UniKlo/PaintBot/README.md

# PaintBot
Paintbot is a machine that paints upright surfaces. It's a prototype that can paint indoor walls. The goal of this prototype is to extend it to paint or draw on walls of any size, indoors and outdoors alike. This document is a wiki for the robot's mechanics, electronics and code.<br/>

| Overview | Demonstration |
:-------------------------:|:-------------------------:
paintbot_v12 |  <br/> Autonomously paints a 3'x 3' square on the wall <br/> [Youtube link](https://www.youtube.com/watch?v=X723J_k0E64&feature=youtu.be)

## Parts
| | **Part** | **Description** |
:---:|:-------------------------:|:-------------------------
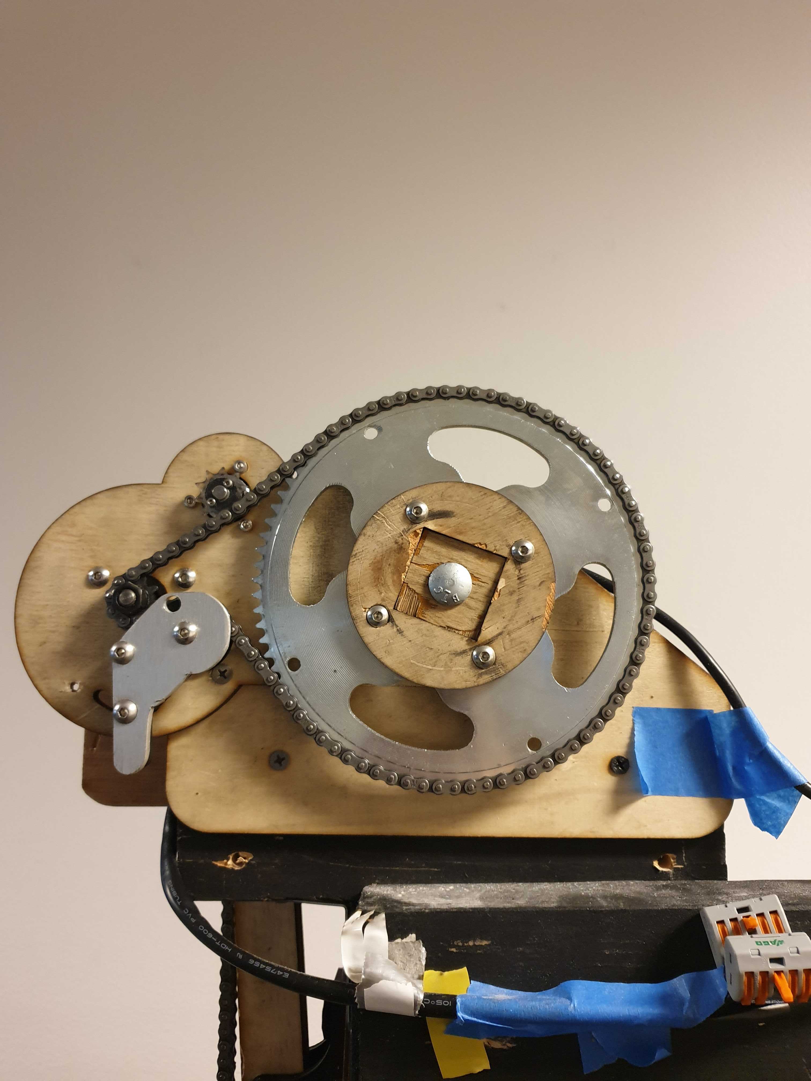
[picture p1: img_gif/motor_rack_with_tensioner_H.jpg]
A. | **Motor Rack with Tensioner** <br/>  | Device that controls the movement of the centerpiece and spray gun by feeding or withdrawing chain from opposite ends <br/><br/> [Design goals, parts, CAD drawings/documents](https://github.com/UniKlo/PaintBot/tree/master/Mechanics/MotorRack) <br/><br/> [How to assemble](https://github.com/UniKlo/PaintBot/blob/master/Mechanics/How%20to%20Assemble/Motor%20Rack%20with%20Tensioner/README.md)
B. | **Frame** <br/>  | <br/> Structure, created with 2" x 4" wood studs, to provide an exoskeleton for the Paintbot <br/><br/> [Design goals](https://github.com/UniKlo/PaintBot/tree/master/Mechanics/Pillar) <br/><br/> [How to assemble](https://github.com/UniKlo/PaintBot/blob/master/Mechanics/How%20to%20Assemble/Frame/README.md)
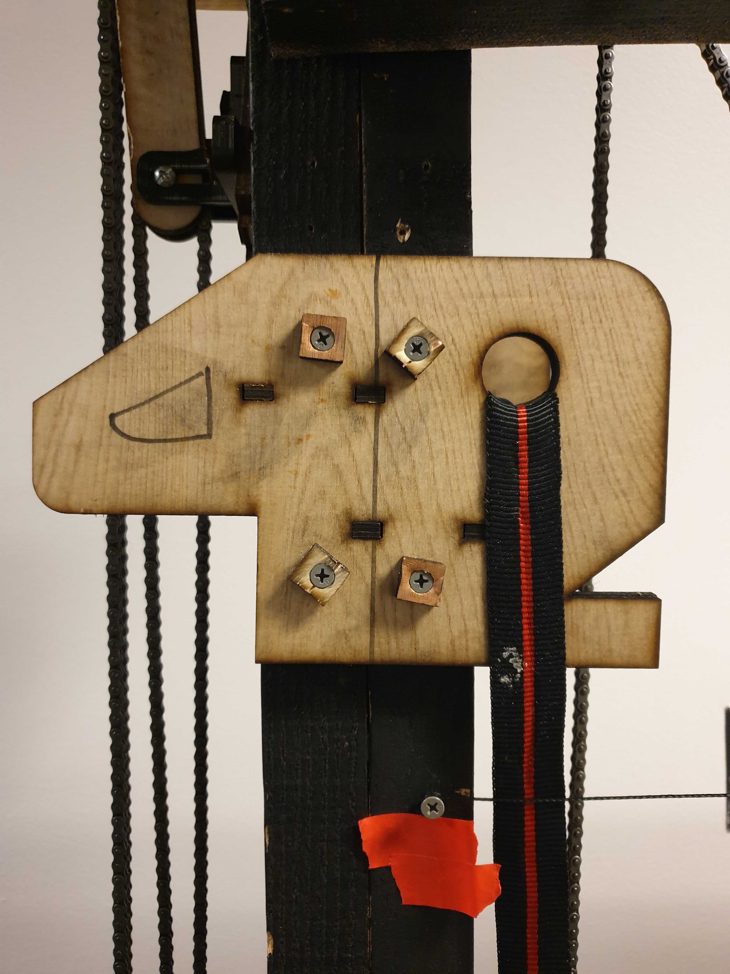
[picture p2: img_gif/safety_brace_H.jpg]
C. | **Safety Brace** <br/>  | Passive device that acts as a physical barrier to prevent the pulley weights from colliding with the bracket under "Motor Rack with Tensioner part" <br/> - Other functions include: <br/> -- Preventing the pulley weights from descending too low <br/> -- Catching the pulley weights in case of chain system failure <br/> -- Strapping the pulley weights in place during transportation of the PaintBot <br/> - Note: Ratchet straps are used in coordination with this passive device <br/> There are a total of 4 Safety Braces on the Frame (2 on the front and back of each pillar) <br/><br/> [Design goals, Force Diagrams, and CAD drawing/documents](https://github.com/UniKlo/PaintBot/blob/master/Mechanics/Safety%20Brace/README.md) <br/><br/> [How to Assemble](https://github.com/UniKlo/PaintBot/blob/master/Mechanics/How%20to%20Assemble/Safety%20Brace/README.md)
D. | **Control Box** <br/> Control Box | Plywood box designed to protect all microelectronics used to receive input or output signal to motors against physical and liquid hazards <br/> [Wiring Schematics, Connections, and Parts](https://github.com/UniKlo/PaintBot/tree/master/Mechanics/Electric%20Circuits)
E. | **Paint Compressor** <br/> Paint Compressor | Magnum Project Painter Plus Electric TrueAirless Sprayer <br/> - Device used to pressurize and spray paint <br/> **Recommendations: For an even coat, each spray layer should have 50% overlay and the spray gun should be 1 foot away from the wall** <br/><br/> [Design considerations](https://github.com/UniKlo/PaintBot/tree/master/Mechanics/Paint%20Compressor) <br/><br/> [How to Connect/Use (Youtube Video by GracoPaintSprayers)](https://www.youtube.com/watch?v=pey29Z3UQR4)
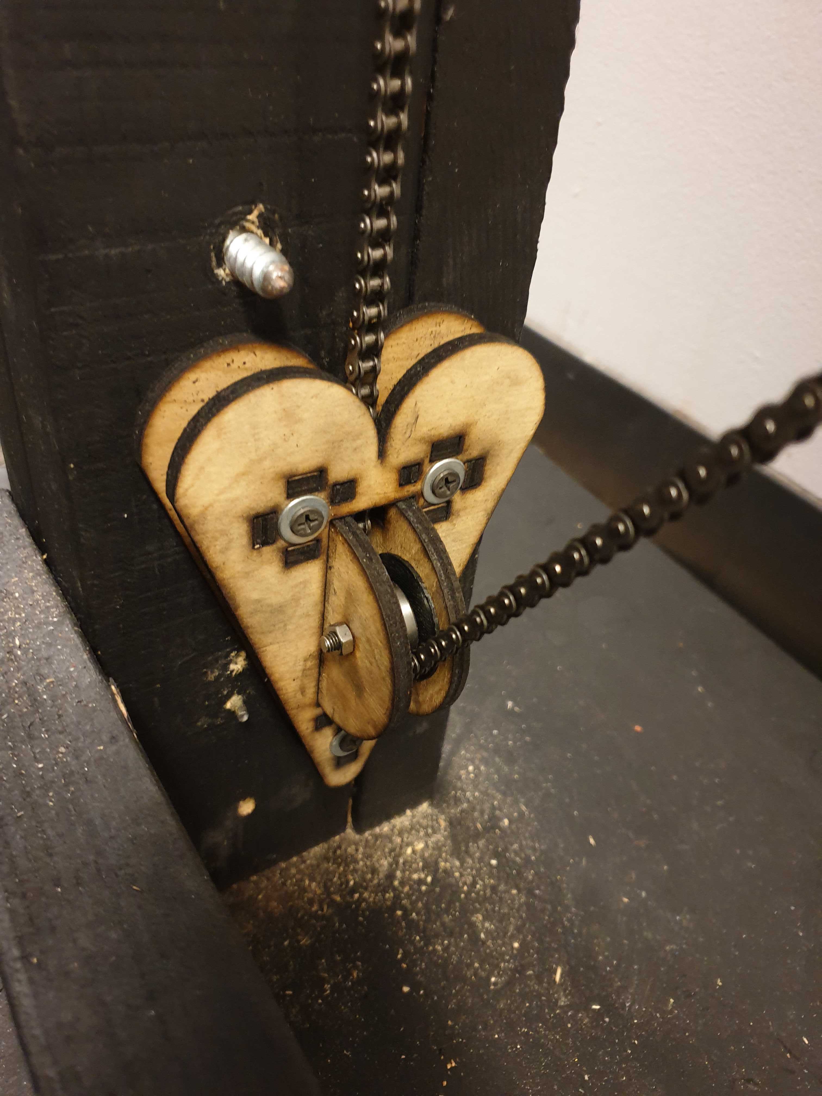
[picture p3: img_gif/safety brackets.jpg]
F. | **Wooden Bracket** <br/> | Device that is designed to handle forces from the tension in the chain system by holding the chain in place during operations <br/><br/> [Design Goals, Force Diagrams, CAD Drawings/Documents](https://github.com/UniKlo/PaintBot/blob/master/Mechanics/Wooden%20Bracket/README.md) <br/> <br/> [How to Assemble](https://github.com/UniKlo/PaintBot/blob/master/Mechanics/How%20to%20Assemble/Wooden%20Bracket/README.md)
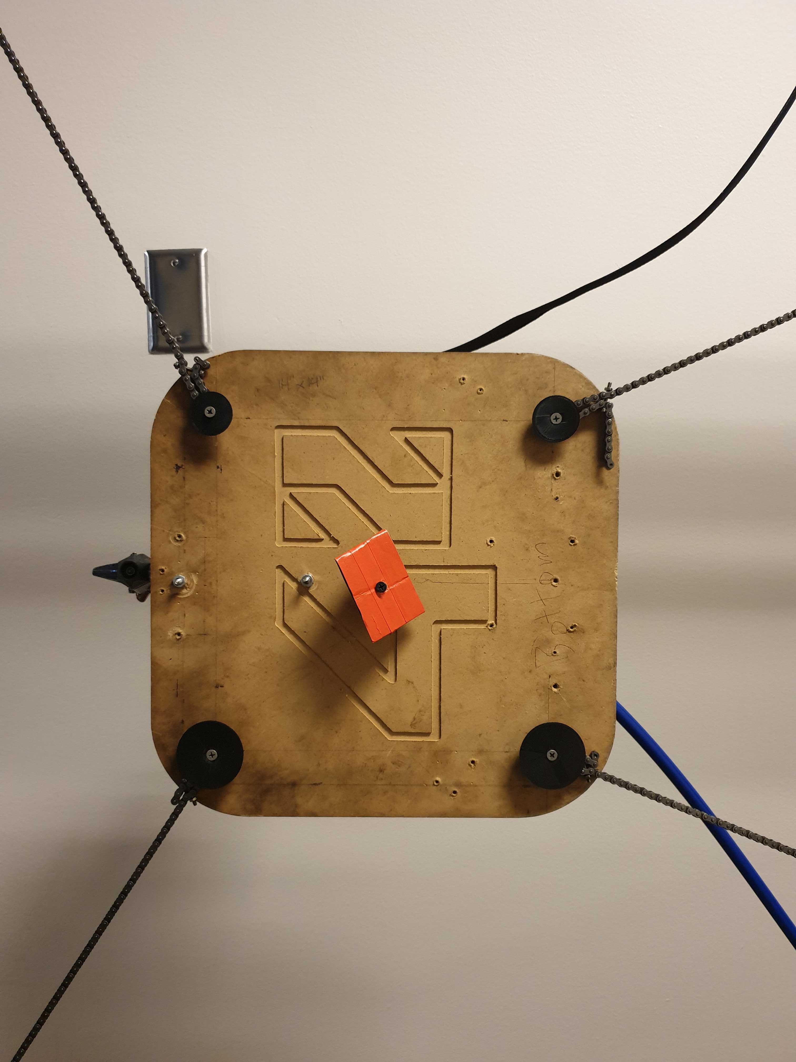
[picture p4: img_gif/center_piece_H.jpg]
G. | **Centerpiece** <br/>  | Placeholder for spray-gun to ensure proper upright position during spraying <br/><br/> [Design goals, Force diagrams, CAD drawing/documents, and Iterations](https://github.com/UniKlo/PaintBot/tree/master/Mechanics/Centerpiece)
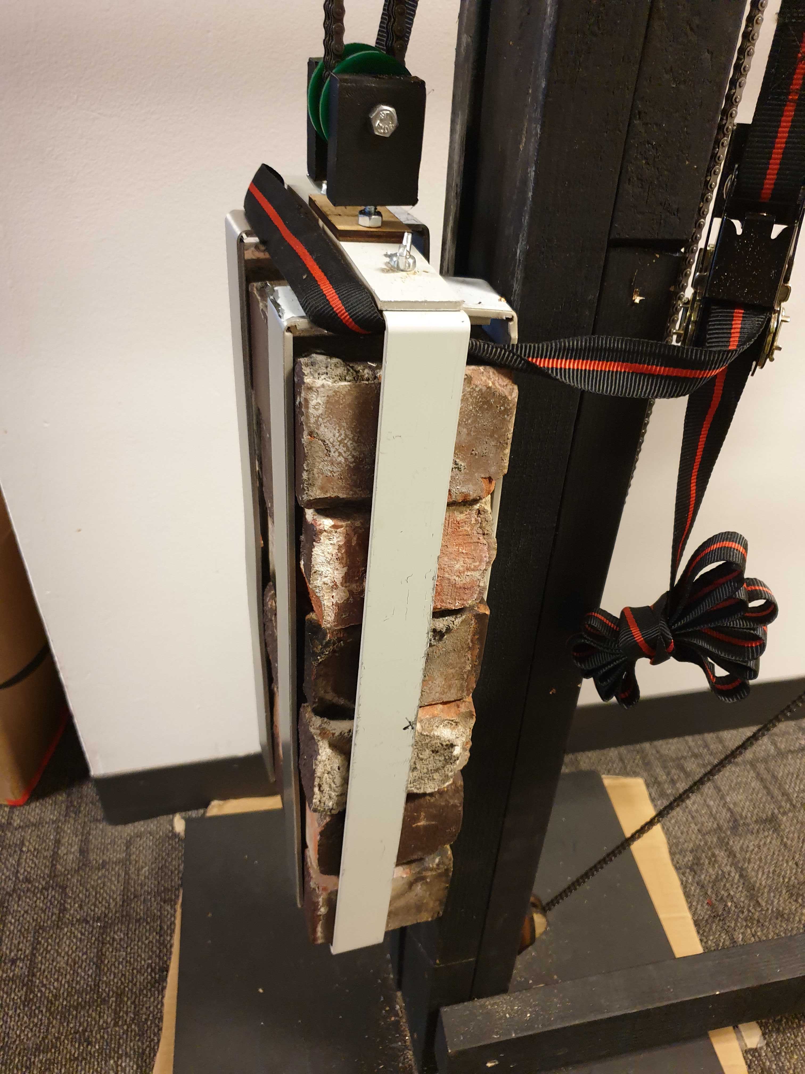
[picture p5: img_gif/pulley weights.jpg]
H. | **Pulley Weight** <br/>   |  Weights used to create tension in our chains to allow Cartesian control <br/><br/> [Design Goals](https://github.com/UniKlo/PaintBot/tree/master/Mechanics/PulleyWeights) <br/> <br/> [How to Assemble](https://github.com/UniKlo/PaintBot/blob/master/Mechanics/How%20to%20Assemble/Pulley%20Weights/README.md)
I. | **Spray Gun Holder** <br/>  | Encasing used to hold the spray gun upright and controls whether to engage or disengage spraying during operation <br/><br/> [Design goals, Parts, CAD drawing/documents](https://github.com/UniKlo/PaintBot/tree/master/Mechanics/SprayGunHolder) <br/><br/> [How to assemble](https://github.com/UniKlo/PaintBot/tree/master/Mechanics/How%20to%20Assemble/Spray%20Gun%20Holder)
J. | **Chain system** <br/> Chain System | Pulley System developed with #25 ANSI Standard Roller Chains to utilize the torque in the motor to control the movement of the Centerpiece in Cartesian plane <br/><br/> [Design considerations, Force diagrams, Parts, and More Photos](https://github.com/UniKlo/PaintBot/blob/master/Mechanics/ChainSystem/README.md) <br/><br/> [Chain Layout](https://github.com/UniKlo/PaintBot/blob/master/Mechanics/How%20to%20Assemble/Chain%20System/README.md)

## Code

### [Working Code](https://github.com/UniKlo/PaintBot/tree/master/DEMO_code)
* Code that was developed in Arduino IDE and uses the readings from the encoders, inside the Motor Rack, to control the displacement of the centerpiece so the PaintBot could spray a 3ft. x 3ft. area on the wall.
* Demonstration conducted on 2019.11.12

### [Future Code (Work in progress)](https://github.com/UniKlo/PaintBot/tree/master/Automatic_Controls)
* Alternative code developed in Arduino IDE using displacement of chain distance to control the movement of the centerpiece during operation. This method uses the relative starting point of the centerpiece as the origin and traverses by vector notation inputs. 

## Previous Iterations
 * [V-Plotter](https://github.com/UniKlo/PaintBot/tree/master/Iterations/V-Plotter)
