UniKlo/PaintBot/DEMO_code/README.md

Paint Bot Image

### Prerequisites

```
Arduino Mega 2560 Rev3 (recommended) or Arduino Uno Rev3
Any computer (Mac OS X, WINDOW, LINUX) to run Arduino IDE
```

### Installing

git clone the repository or download the zip file, then go to paintbot folder

```
$ git clone https://github.com/movingfinger/hardware-piscine.git
$ cd hardware-piscine/
$ cd paintbot/
open paintbot.ino with Arduino IED.
```

installing images

## Running the tests

Paint Bot (https://youtu.be/X723J_k0E64 "Paint Bot")

## Acknowledgments

* 42 Silicon Valley
* 42 Robolab
