UniKlo/PaintBot/Mechanics/Electric Circuits/README.md

# Electric Circuits

## Wiring

Breadboard used to connect all 5V(+) and all GND(-) to Arduino's 5V and GND output<br/>
Motors connections must be PWM enabled and Encoders must be Interrupt enabled pins



## Connections

| Part | Description |
| :---: | :--- |
**Arduino** <br/> Arduino Mega 2560 |  All microelectronics server, controling actions by analogic and digital inputs and outputs <br/> <br/> [Arduino Mega 2560 Rev3](https://store.arduino.cc/usa/mega-2560-r3)
**Power Supply** <br/> MENZO 12 Volts Power Supply | Transforms power outlet output to safe input for all microelectronics <br/> <br/> [MENZO 12v 30a Dc Universal Regulated Switching Power Supply 360w](https://www.amazon.com/MENZO-Universal-Regulated-Switching-Computer/dp/B06VWV5YCH)
**Joystick** <br/> Joystick | Mannualy controls the centerpiece x and y axis movement and activate the path coded <br/> <br/> [Game Controller Sensor JoyStick](https://www.amazon.com/HiLetgo-Controller-JoyStick-Breakout-Arduino/dp/B00P7QBGD2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)
**H-Bridge** <br/>  | Controls the output signal to the motors so they can operate safely within specifications <br/> <br/> [IBT-2 H-Bridge with Arduino](http://www.hessmer.org/blog/2013/12/28/ibt-2-h-bridge-with-arduino/)
**Rotary Encoder** <br/> Rotary Encoder | Keeps track of the chain motor rotation, furthermore transfering that information to the Arduino(Code) <br/> <br/> [Optical encoder 360 ppr LPD3806-360BM-24C AB Two Phase Incremental optical shaft 6mm Rotary Encoder 360 Pulses lines](https://sdgteach.en.alibaba.com/product/60729529433-806678094/Optical_encoder_360_ppr_LPD3806_360BM_G5_24C_AB_Two_Phase_Incremental_optical_shaft_6mm_Rotary_Encoder_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)
**Motor** <br/> Scooter Motor | Controls the chain-centerpiece movement <br/> <br/> [24 Volt 100 Watt MY6812 Electric Motor with 9 Tooth #25 Chain Sprocket](https://www.monsterscooterparts.com/rae124vo100w.html)
**Z Motor** <br/> Z-Axis motor | Controls the rotation of the Trigger control piece <br/> <br/> [Motor from MakerMadeCNC.com](https://www.makermadecnc.com/product/z-axis-replacement-motor/)
