UniKlo/PaintBot/Mechanics/PulleyWeights/README.md

# Pulley Weight


## Design Goals
* Develop control in 2D Cartesian plane with the use of tension in the chains
  * Achieved by using a pulley system with weights to create tension
* Minimum cost
  * Bricks were readily available (other forms of weights can be used)
  * Encasing was custom-made from aluminum scraps to hold bricks

## Parts
| | Part | Description |
|:-| :--:| :--- |
A. | **Weight Connect** <br/>  | 3D printed part used to connect the metal encasing to to pulley system <br/> printed with 70% infill <br/><br/> [Fusion document](https://a360.co/2piFbqn)
B. | **acrylic cut chain guide** <br/>  | 3D printed bearing shaft used to guide the chains holding the pulley weight
C. | **Brick** <br/> Brick | Clay bricks (~2.3 kg ea) layered on top of each other encased in a metal frame <br/> 6 bricks were used, giving an approximate of 13 kg <br/><br/> [4 in. x 2 in. x 8 in. Red Concrete Brick](https://www.homedepot.com/p/4-in-x-2-in-x-8-in-Red-Concrete-Brick-100003009/100321940)
