UniKlo/PaintBot/Mechanics/ChainSystem/README.md

# Chain System

The goal of the centerpiece is to be able to move to any edge of the painting frame while constrained at each corner by tensioned chains. Via pulleys, the chain system allows that to happen by creating a pulling force via weights and by shortening the chain.

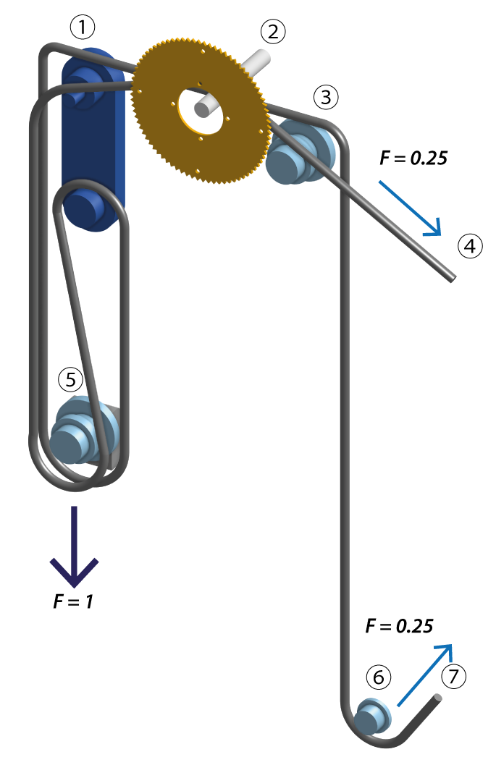
[picture p6: Mechanics/ChainSystem/chain-system-02-01.png]


1. Double Bearing Pulley that guides the chains through the Motor Rack.
2. 10 teeth #25 sprocket, connected to bolt, that drives the motion of the chains by using the torque translated from the motor inside the [Motor Rack](https://github.com/UniKlo/PaintBot/tree/master/Mechanics/MotorRack).
3. Double Bearing that guides the chains to the Wooden Bracket and to the Centerpiece
4. Connection to Top Corner of Centerpiece
5. Weight holder connects to [Pulley Weight](https://github.com/UniKlo/PaintBot/tree/master/Mechanics/PulleyWeights) to add tension to the system.
6. Single bearing attached to bottom of the pillar, encased in [Wooden Bracket](https://github.com/UniKlo/PaintBot/blob/master/Mechanics/Wooden%20Bracket).
7. Connection to Bottom Corner of Centerpiece

## Design considerations

* Develop a chain system that keeps the centerpiece stable during operation
  * Centerpiece held in place from the tension of two equal weights on opposite sides
  * The tension in the chains stables and prevents the Centerpiece from vibrating violently during spraying
* Increase efficency and safety during operations
  * Increasing mechanical advantage by using 1:4 Pulley System: Refer to diagram below.
  * Limit the range of distance the Pulley Weight travels while increase operating range of centerpiece 
    * Limiting the distance the Pulley Weight travels reduces the likelihood of it colliding with people underneath
    * Increasing operating range of centerpiece is practical in achieving more paint coverage

Pulley Systems

## Parts
| Part | Description |
| :--: | :-- |
**ANSI #25 Roller Chain** <br/> 25 ANSi Chain | - ANSI Chain No. 25 used to connect the pulley systems <br/> - 140 lbs is the rated working load of the chain <br/> - [Specifications](https://www.renoldjeffrey.com/media/2395574/ansi-standard-roller-chain-renold-jeffrey.pdf)

## Photos
| &nbsp; | &nbsp; | &nbsp; |
|:-:|:-:|:-:|
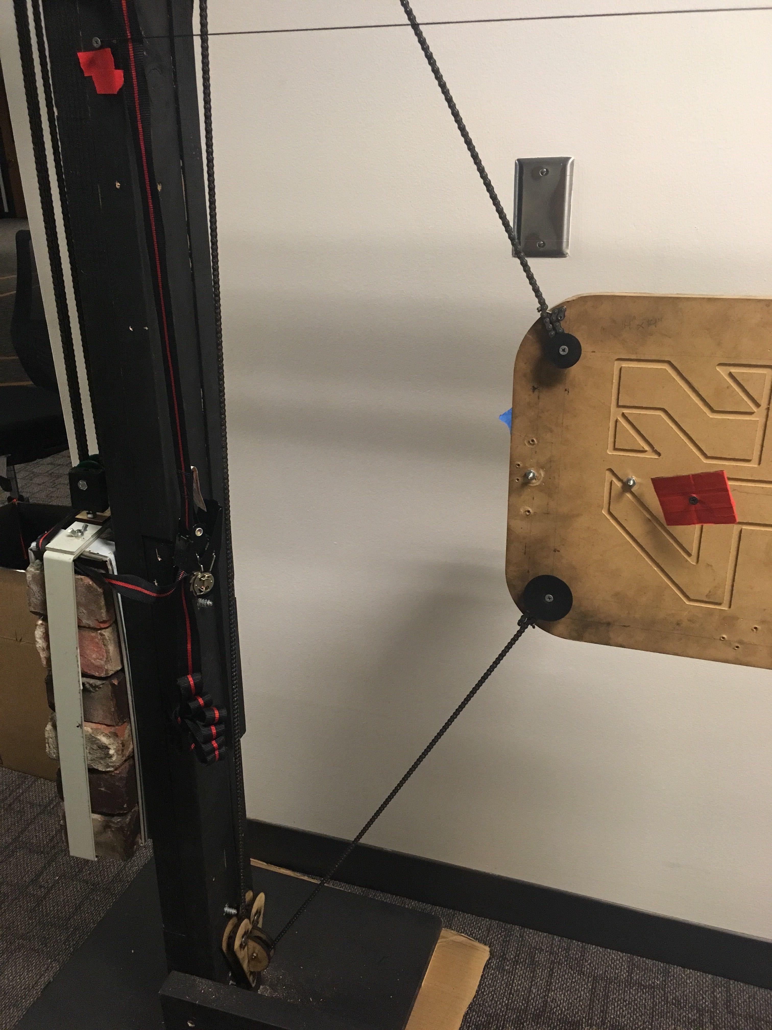
[picture p7: Mechanics/ChainSystem/Image from iOS.jpg]
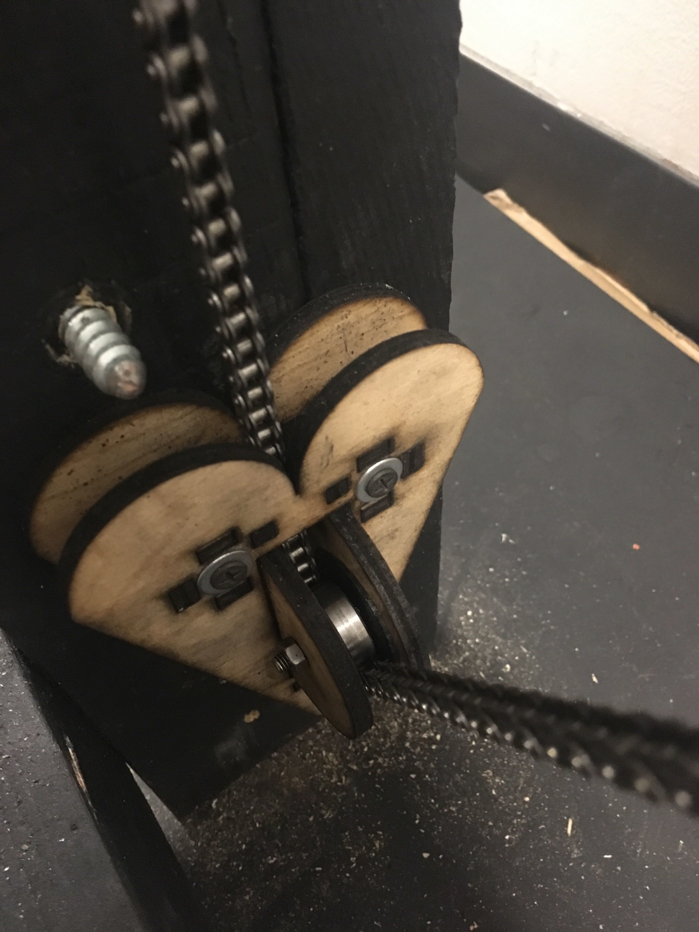
[picture p8: Mechanics/ChainSystem/Image from iOS (2).jpg]
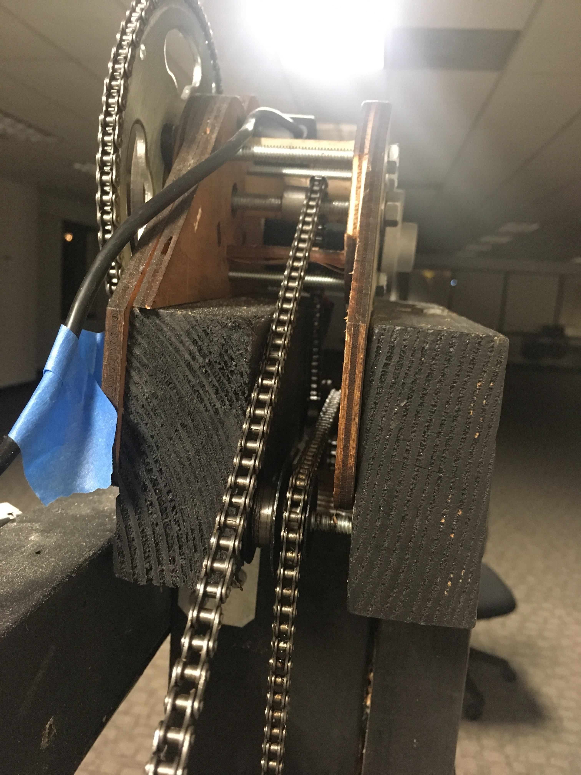
[picture p9: Mechanics/ChainSystem/Image from iOS (3).jpg]
**Chain by centerpiece** <br/>  | **Chain by Wooden Bracket** <br/>  | **Chain by Motor Rack(In)** <br/> 
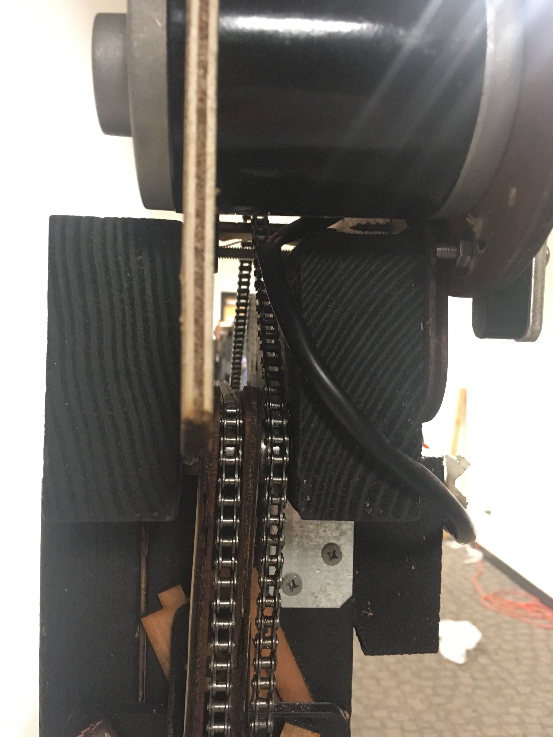
[picture p10: Mechanics/ChainSystem/Image from iOS (5).jpg]
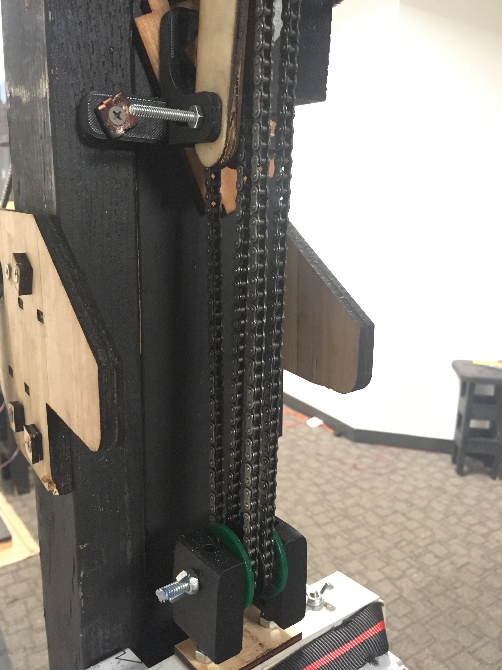
[picture p11: Mechanics/ChainSystem/Image from iOS (4).jpg]
**Chain by Motor Rack(Out)** <br/>  | **Chain above Pulley Weight** <br/>
