UniKlo/PaintBot/Mechanics/Pillar/README.md

# Frame



## Design goals
* Create a structure addressing the following points:
  * Low-cost to manufacture 
    * Cost of materials is less than 75 USD
  * Easy to access and modify 
    * Basic structure gives plenty of room for modification for future iterations
    * Ex. The height of the pillars can be adjusted to paint at higher elevations
  * Waterproof 
    * Stain each piece with waterproof paint before assembly 
  * Has 4 anchor points 
    * Dimensions are arbitary as we only need 4 anchor points to fully operate the PaintBot
  
## Parts
| Part | Description |
| :--: | :---  |
**2"x4" Wood Stud** <br/>  | [2 in. x 4 in. x 96 in. Premium Kiln-Dried Whitewood Stud](https://www.homedepot.com/p/2-in-x-4-in-x-96-in-Premium-Kiln-Dried-Whitewood-Stud-161640/2020912200)
**Waterproof Paint** <br/> Waterproof paint | [1 gal. #SC-102 Slate Solid Color Waterproofing Exterior Wood Stain and Sealer](https://www.homedepot.com/p/BEHR-Premium-1-gal-SC-102-Slate-Solid-Color-Waterproofing-Exterior-Wood-Stain-and-Sealer-501301/204166088)

[How to Assemble](https://github.com/UniKlo/PaintBot/blob/master/Mechanics/How%20to%20Assemble/Frame/README.md)
