UniKlo/PaintBot/Mechanics/MotorRack/README.md

# Motor Rack with Tensioner

      

For full design view: [OnShape Document](https://cad.onshape.com/documents/c35a5db4d6efdd4b831e7e66/w/d232ff81f911a9e59ca8bc06/e/0a6c8383d003cd06b363736f)

### Design goals

* Align the encoder, motor, Sprockets for safe and consistently operations
* Use the least amount of power to control movement of centerpiece while increasing mechanical advantage of motor 

| Equations and Assumptions based off Motor [Specifications](https://www.monsterscooterparts.com/rae124vo100w.html) |
| :--- |
| *Assumptions* |
| 9 Tooth #25 chain <br/> ⇒ Pitch = ¼ “ <br/> ⇒ # of Teeth (N) = 9 <br/> Radius of sprocket = PD2 <br/> 1” = 2.54 cm <br/> 1 kg = 2.2 lbs <br/> 1 N = 1 kg * 9.8 m/s2 <br/> Torque = Force x perpendicular distance  <br/> Perpendicular distance = radius of sprocket <br/> Pitch Diameter (PD) = Pitch(P) / sin(180 / N) |
| *Calculations* |
| Torque = Force x distance <br/> Torque = (Weight) x (radius of 9 teeth sprocket on motor) <br/> Torque = Weight x PD / 2 <br/> Torque = Weight x Pitch(P) / 2 * sin(180 / N) <br/> Weight = Torque * 2sin(180/N) /Pitch = 0.34 Nm * 2sin(180 / 9) / 0.25" * 1" / 0.0254 m * 1 / 9.8 m/s2 <br/> <br/> **Max Weight Motor can lift = ~10 kg = ~22 lbs** <br/> **Note: Pulley system is designed as a 1:4 pulley system (Mechanical Advantage = 4) so motor is just pulling ¼ * hanging weight (currently hanging weight is 27 lbs) <br/> Refer to Chain System for force diagram of pulley system** |

## Parts
| | Part | Description |
|:-: | :---: | :--- |
A. | **Motor** <br/> Scooter Motor | [24 Volt 100 Watt MY6812 Electric Motor with 9 Tooth #25 Chain Sprocket](https://www.monsterscooterparts.com/rae124vo100w.html)
B. | **Rotary Encoder** <br/> Rotary Encoder | [Optical encoder 360 ppr LPD3806-360BM-24C AB Two Phase Incremental optical shaft 6mm Rotary Encoder 360 Pulses lines](https://sdgteach.en.alibaba.com/product/60729529433-806678094/Optical_encoder_360_ppr_LPD3806_360BM_G5_24C_AB_Two_Phase_Incremental_optical_shaft_6mm_Rotary_Encoder_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)
C. | **Sprocket** <br/>  | [ANSI 25 Chain, 10 Teeth, for 1/4" Shaft Diameter](https://www.mcmaster.com/6799k2)
D. | **Bearing** <br/>  | [zz809 abec 7 deep groove ball bearing](https://www.alibaba.com/product-detail/High-precision-zz809-abec-7-deep_60718249836.html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)
E. | **Gear Bolt** <br/> |[ Hillman 5/16-in x 4-in Galvanized Coarse Thread](https://www.lowes.com/pd/Hillman-5-16-in-x-4-in-Coarse-Thread-Carriage-Bolt/1000381581)
F. | **Cage Bolt** <br/>  | [10-24 x 1/2" Machine Screws / Phillips](https://www.mcmaster.com/91772a253)
