UniKlo/PaintBot/Mechanics/SprayGunHolder/README.md

# Spray Gun Holder


## Design Goals
* Stablize spray gun during operation
  * Created handle holder inserts to keep spray gun handle snugly fitted into encasing
  * Front and back support created by 3D printing peices using Ender-3 3D printer with PLA filament
* Establish control over trigger handle
  * Motor attached to encasing that rotates trigger press at exact angles to engage/disengage trigger on spray gun

## Parts
| | Part | Description |
|:-: | :--: | :-- |
A. | Handle holder back support <br/>  | Support holder for the back of the spray gun in encasing <br/> Designed based off generative design from Fusion360 <br/> <br/> [Fusion document](https://a360.co/32H2Jmt)
B. | Handle holder front support <br/>  | Support holder for the front of the spray gun in encasing <br/> Designed based off generative design from Fusion360 <br/> <br/> [Fusion document](https://a360.co/2NJBYti)
C. | Trigger control <br/>  | Piece that is attached to the motor and rotates a set angles to press/release the trigger of the spray gun <br/> Designed based off generative design from Fusion360 <br/> <br/> [Fusion docuemnt](https://a360.co/2qdF6o9)
D. | Spray gun case plate <br/> spray gun case plate | Plate used to sandwich the spray gun to attach encasing to the centerpiece <br/> <br/> [Onshape Document](https://cad.onshape.com/documents/1afd4bb96db52c9d48902d08/w/6062089c01f4dd5aed92443b/e/296895f7a25a43b16682dfb6)
E. | Motor <br/> Z-Axis motor | Controls the rotation of the Trigger control piece <br/> <br/> [Motor from MakerMadeCNC.com](https://www.makermadecnc.com/product/z-axis-replacement-motor/)
