UniKlo/PaintBot/Mechanics/Wooden Bracket/README.md

# Wooden Bracket
|  | 
| :---: |
## Design Goals
* To be able to withstand the tension of the chain during operation (Tested: Holds 50kg without deforming or breaking)
* To create a bracket at low cost
* To add aesthetic detail as well as signify our love for this robot

## Force Diagrams


## Materials Used
* Plywood
* [Groove ball bearing](https://www.alibaba.com/product-detail/High-precision-zz809-abec-7-deep_60718249836.html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)
* [Nut](https://www.amazon.com/Hillman-140021-Hex-Machine-Screw/dp/B000BQ8DE8)
* [Bolt](https://www.mcmaster.com/91772a253)
* [Screws](https://www.homedepot.com/p/Pro-Twist-7-x-2-in-Phillips-Bugle-Head-Coarse-Thread-Drywall-Screws-CS2005/207018690) with washers

## CAD Documents

[Onshape](https://cad.onshape.com/documents/624bd94863b6c90403dc5483/w/e8e3d16901bbc782d0261a55/e/36c21db174f8b530e2a3a4fc)

Wooden Bracket
