UniKlo/PaintBot/Mechanics/PulleySystem/README.md

# Safety Brace and Brackets (No longer in use)

## Safety Braces:

[Safety Brace CAD Link](https://cad.onshape.com/documents/6523397c12b1fe32c912b347/w/76bad9a677bbf1a6424c2140/e/f8c4142a4f75009b7d56d12f)

Note: Part was assembled by 2 braces stacked on top of each other along with 4 face connectors to join the 2 braces together (all laser-cut from plywood)

        

Bumper on one side of the brace to prevent the weights from going too high and colliding with the motor box 

Other side of the brace has a hole to hook a ratchet strap to weights for two dual purposes: 
1. Tying weights down during transportation 
2. Preventing weights from falling too far 
- Brace able to hold weight from 2 ft drop

[Ratcheting strap](https://www.harborfreight.com/500-lb-capacity-1-in-x-14-ft-ratcheting-tie-down-61295.html) rated to hold 500 lb

## Chain bearing Holders

### Under Motor Box:

[CAD link](https://cad.onshape.com/documents/203398b8404b63665684f4c1/w/9d3ad5e87b235fabc014cf89/e/3029e69dfe6cc6b4cb731cfa)

- Can withstand ~36 lbs
- Part was 3D printed with Ender-3 using PLA filament
    - [Nut](https://www.amazon.com/Hillman-140021-Hex-Machine-Screw/dp/B000BQ8DE8) and [bolt](https://www.mcmaster.com/91772a253) used
    - [Groove ball bearing](https://www.alibaba.com/product-detail/High-precision-zz809-abec-7-deep_60718249836.html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)



### Bottom corner of frame

[CAD link:](https://cad.onshape.com/documents/624bd94863b6c90403dc5483/w/e8e3d16901bbc782d0261a55/e/36c21db174f8b530e2a3a4fc)

- Can withstand ~50 kg without deforming or breaking
- Part was assembled by laser cutting pieces from plywood and fitting all pieces together
    - [Nut](https://www.amazon.com/Hillman-140021-Hex-Machine-Screw/dp/B000BQ8DE8) and [Bolt](https://www.mcmaster.com/91772a253) used
    - [Screws used](https://www.homedepot.com/p/Pro-Twist-7-x-2-in-Phillips-Bugle-Head-Coarse-Thread-Drywall-Screws-CS2005/207018690)
    - [Groove ball bearing](https://www.alibaba.com/product-detail/High-precision-zz809-abec-7-deep_60718249836.html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)
