UniKlo/PaintBot/Mechanics/MotorBlock/README.md

# Motor Block

### Attach Motor Rack to Pillar:

the front brick metal bracket 

2 bearings on each side of the wooden brick



the back brick is secured by the giant bolt from the middle



2 bearings on each side of the wooden brick

plywood chain guider piece does not have a design



2 bearings on pully

holder block design is in the fusion

chain guider / bearing shaft is in the fusion
