UniKlo/PaintBot/Automatic_Controls/PaintBotAutomaticControls/PaintBotUMLDiagram.png

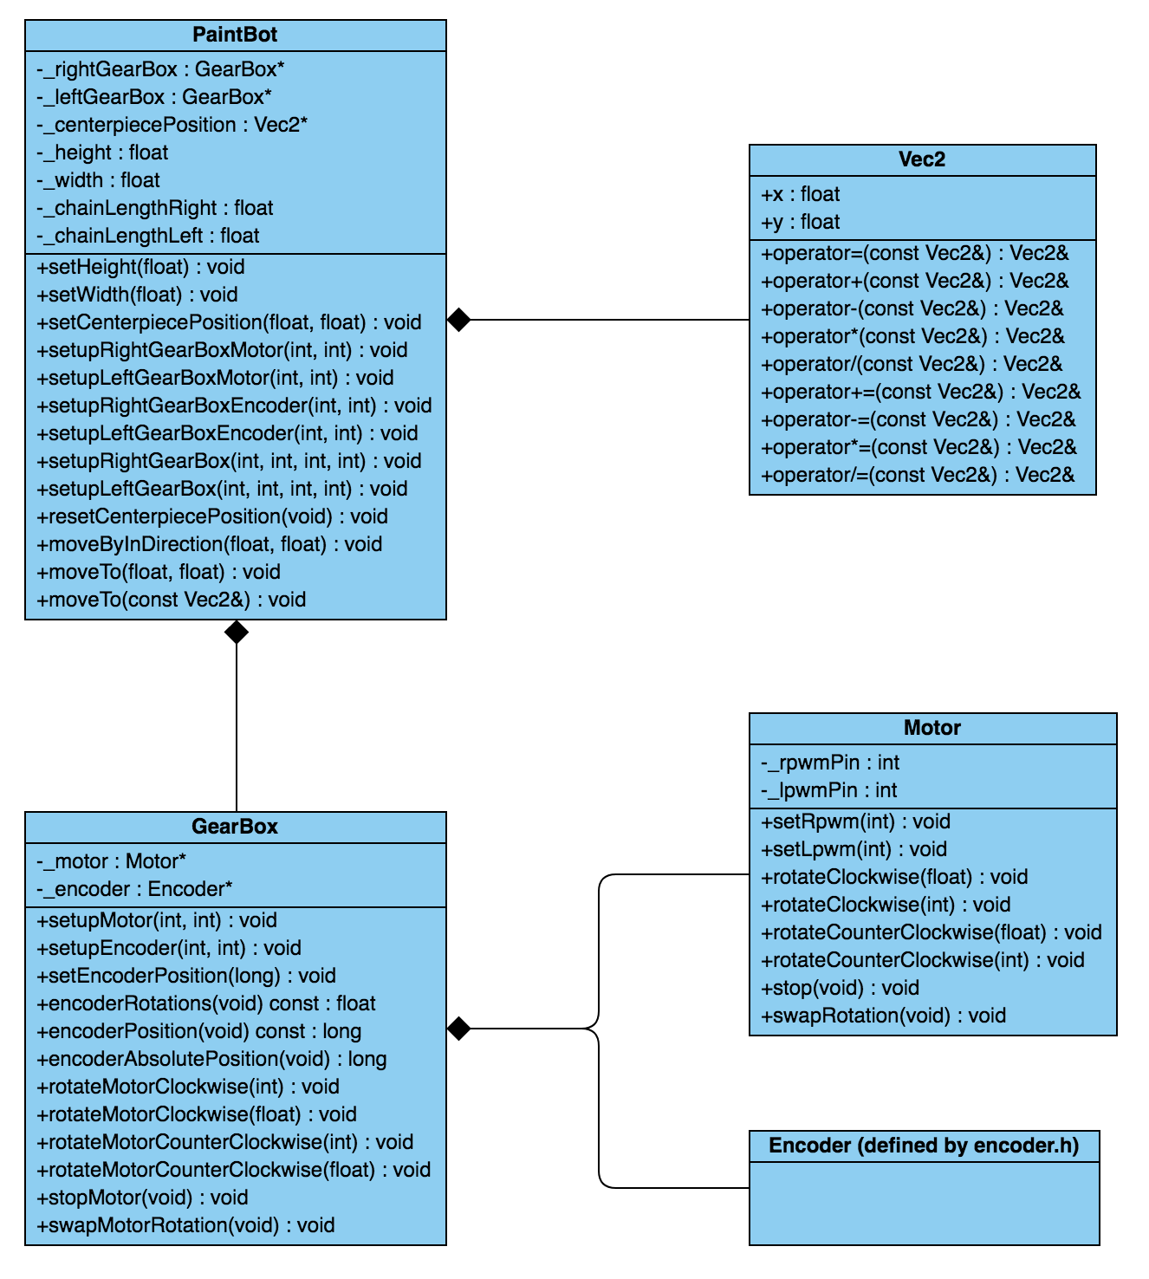
Automatic_Controls/PaintBotAutomaticControls/PaintBotUMLDiagram.png
