UniKlo/PaintBot/img_gif/center piece.jpg

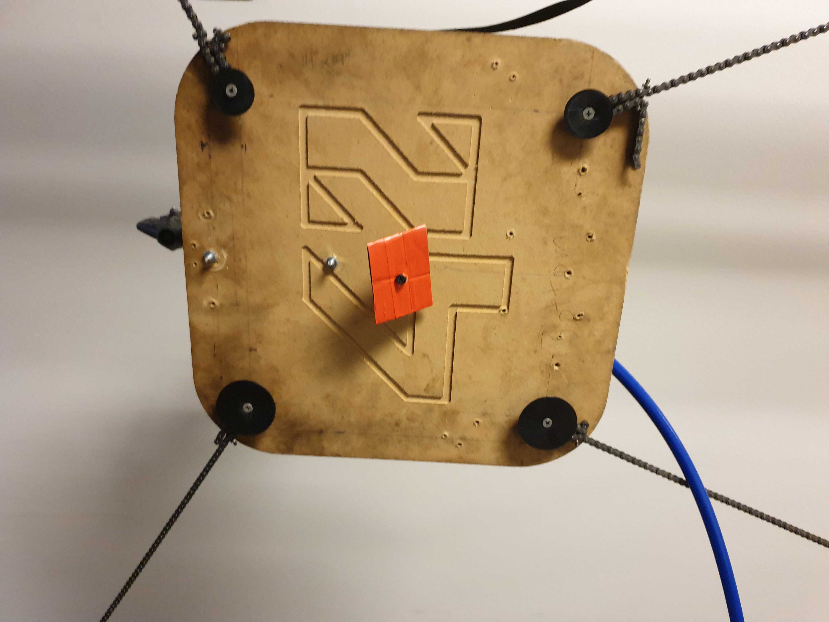
img_gif/center piece.jpg
