UniKlo/PaintBot/img_gif/electronic circuits.jpg

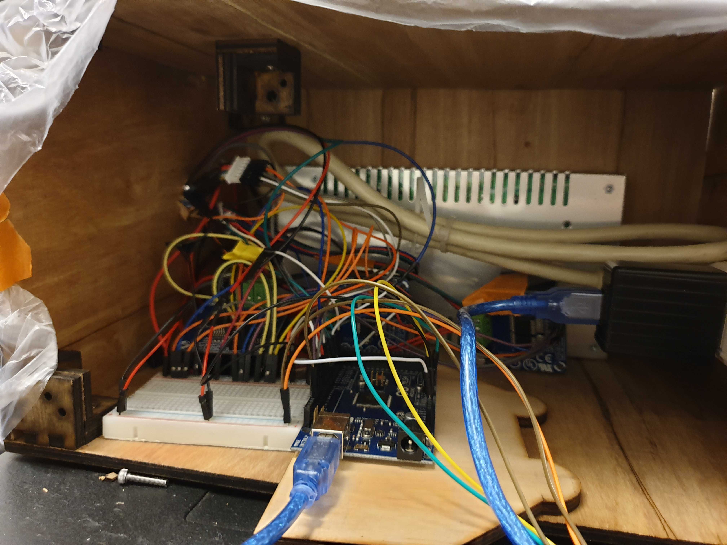
img_gif/electronic circuits.jpg
