UniKlo/PaintBot/img_gif/HorizontalBracesDrawing.jpg

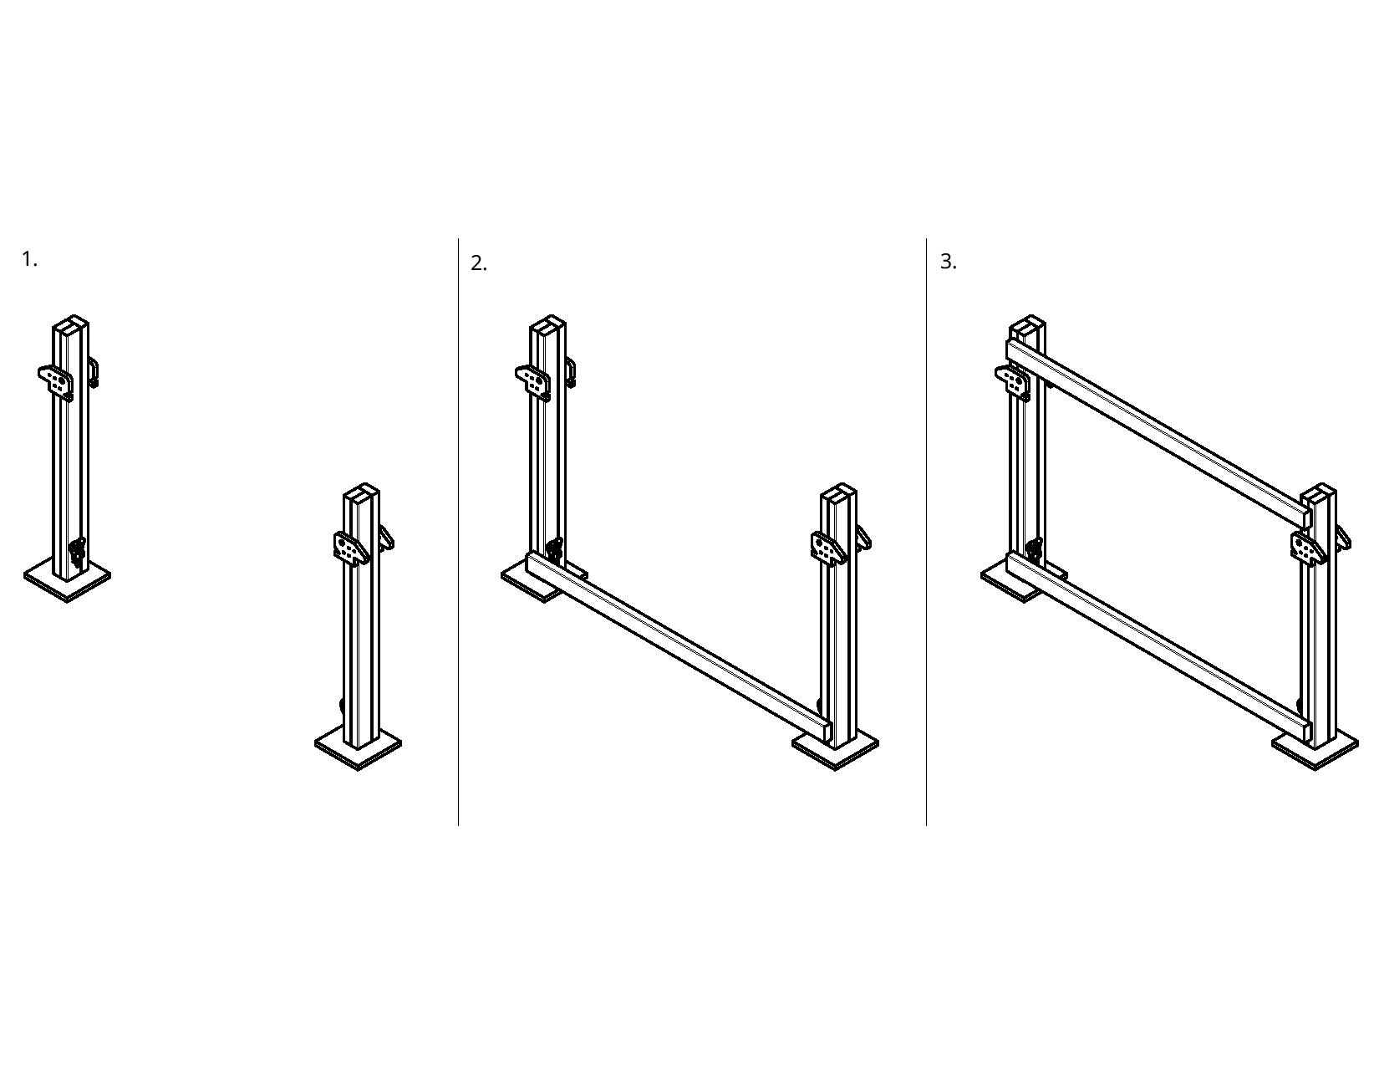
img_gif/HorizontalBracesDrawing.jpg
