UniKlo/PaintBot/img_gif/motor rack with tensioner.jpg

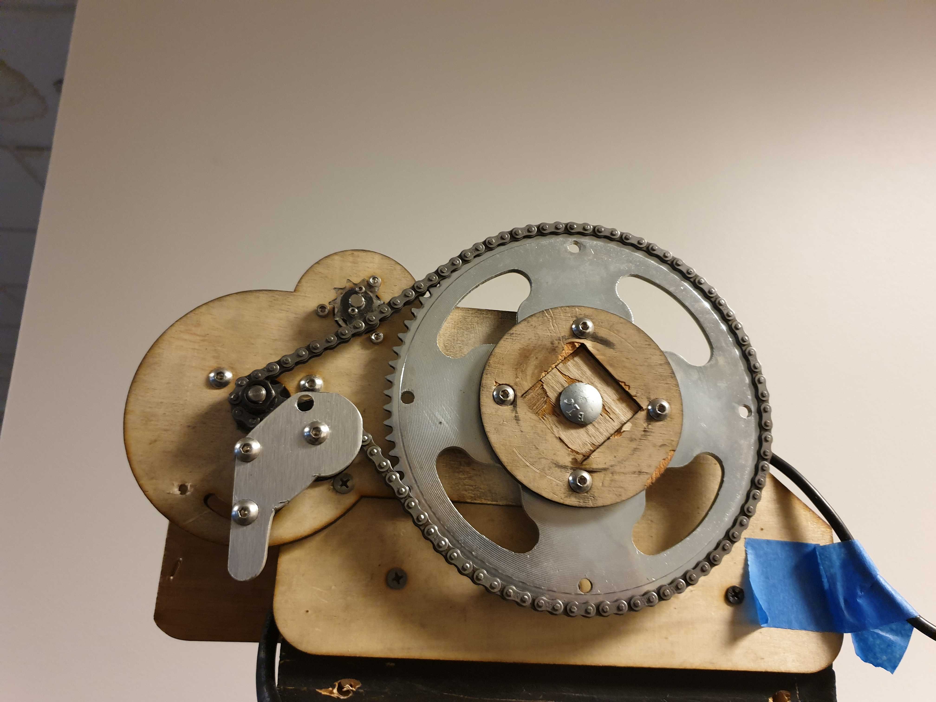
img_gif/motor rack with tensioner.jpg
