UniKlo/PaintBot/img_gif/MotorRackSupportsDrawing.jpg

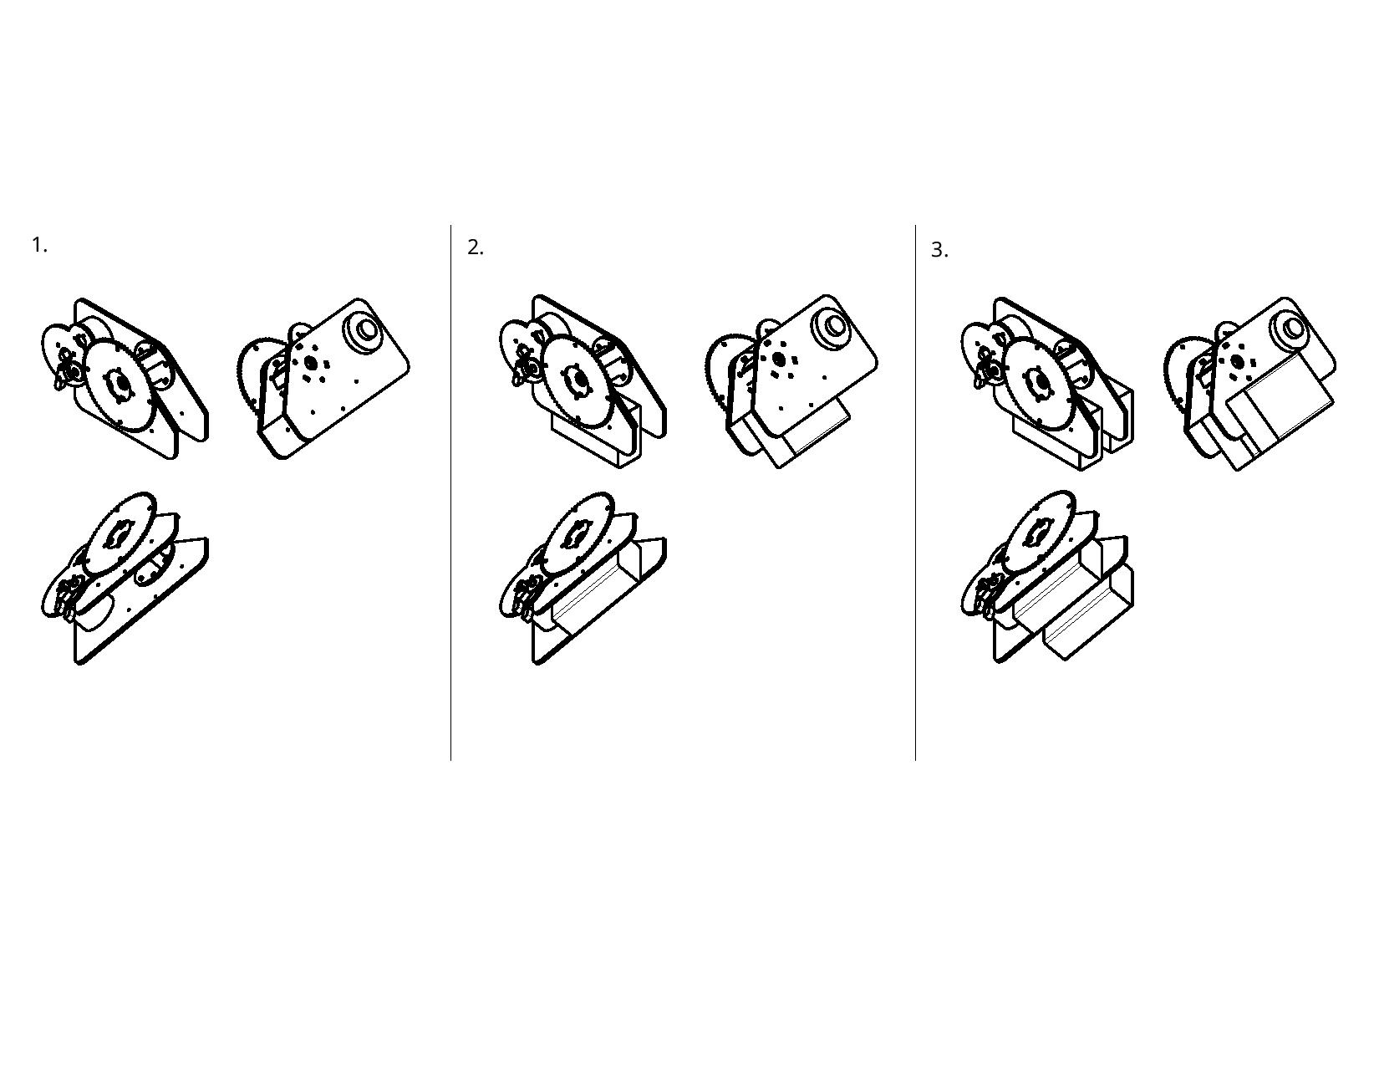
img_gif/MotorRackSupportsDrawing.jpg
