UniKlo/PaintBot/img_gif/Paintbot1.png

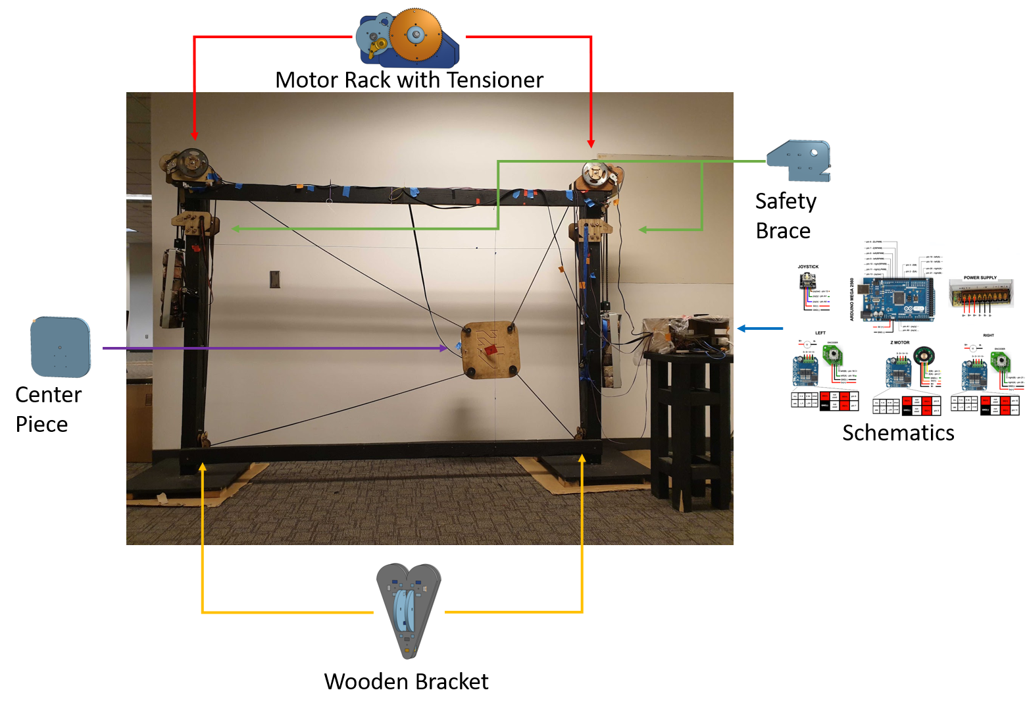
img_gif/Paintbot1.png
