UniKlo/PaintBot/img_gif/paintbot_v5.png

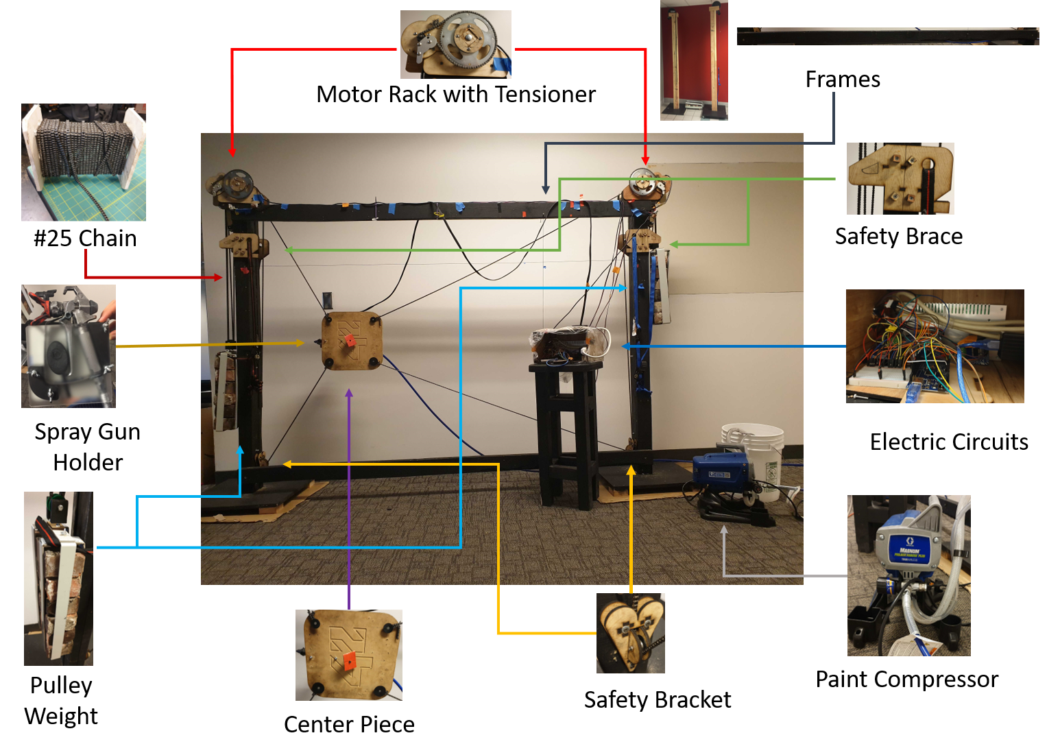
img_gif/paintbot_v5.png
