UniKlo/PaintBot/img_gif/safety brace.jpg

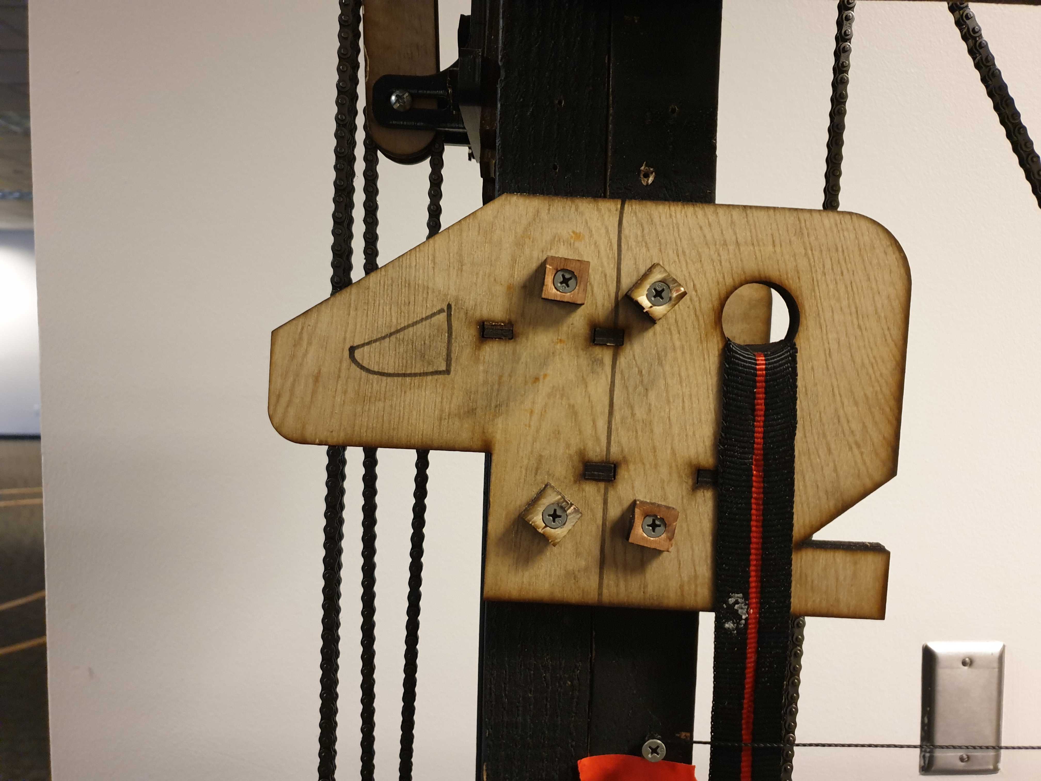
img_gif/safety brace.jpg
