UniKlo/PaintBot/img_gif/side.jpg

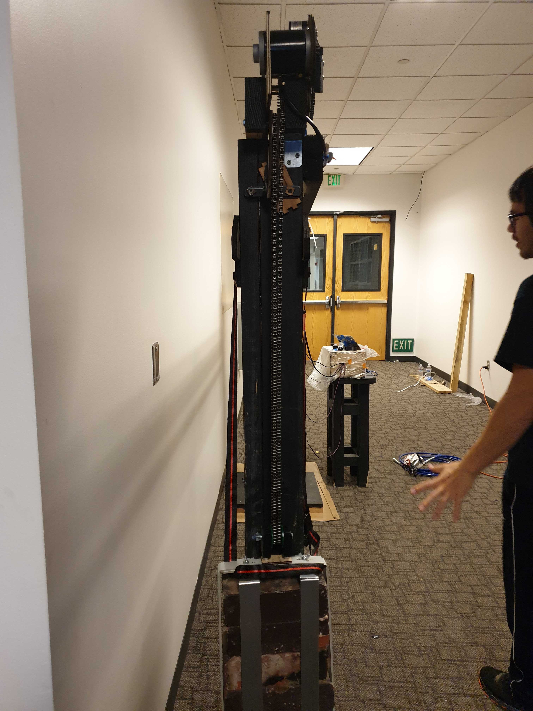
img_gif/side.jpg
