UniKlo/PaintBot/img_gif/VerticalSupportAccessoriesDrawing.jpg

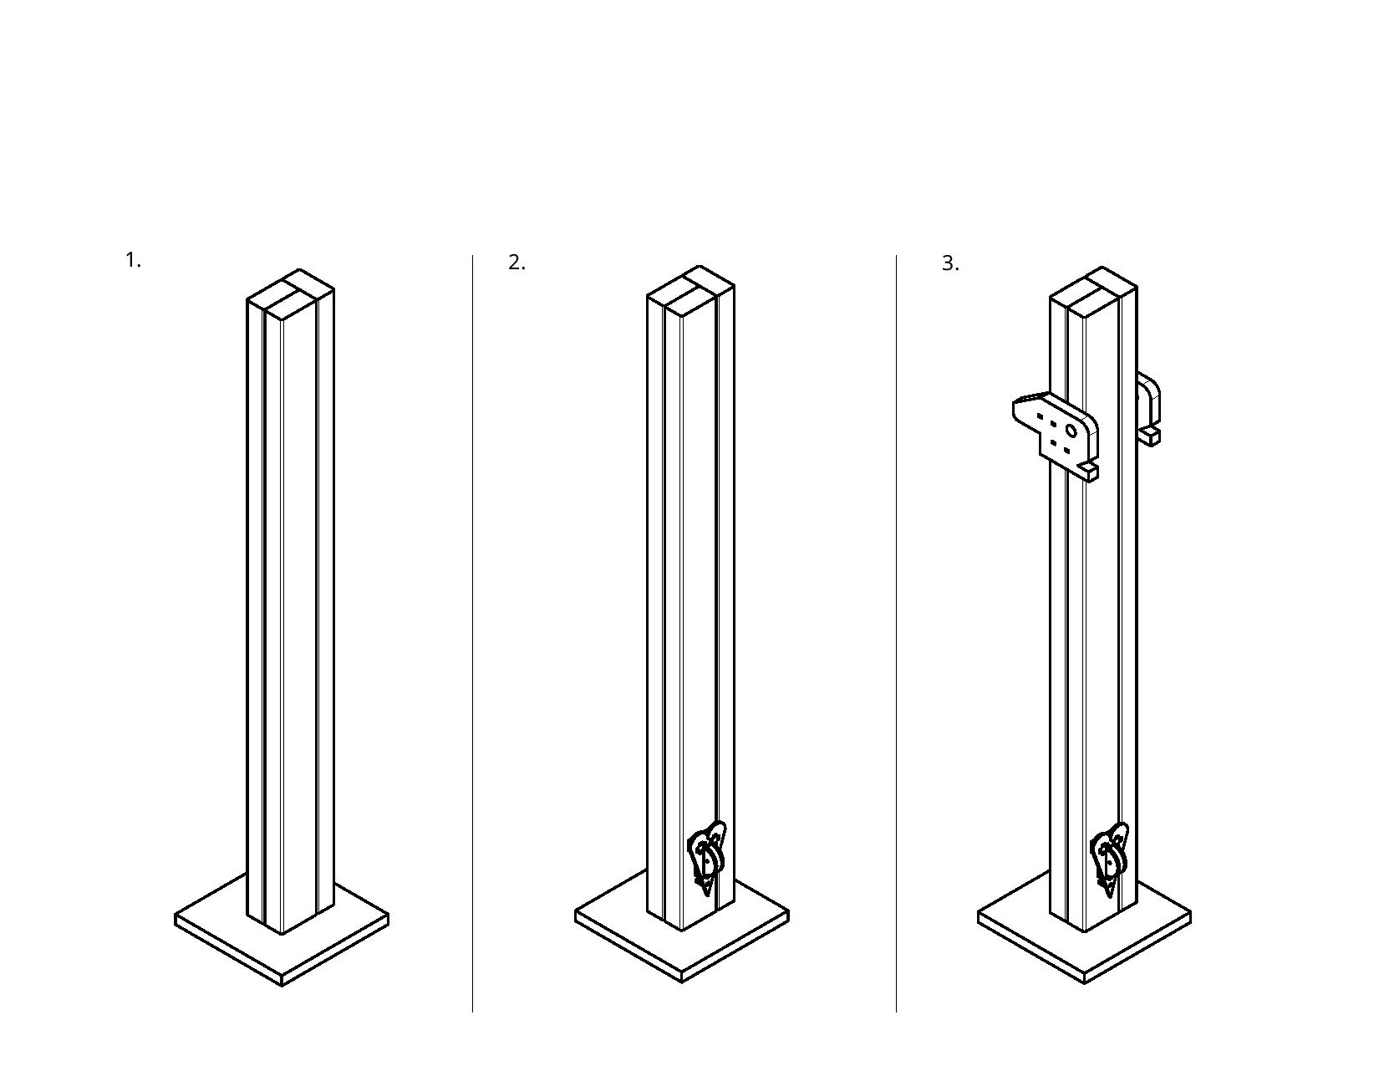
img_gif/VerticalSupportAccessoriesDrawing.jpg
