UniKlo/PaintBot/Mechanics/ChainSystem/untitled (14).png

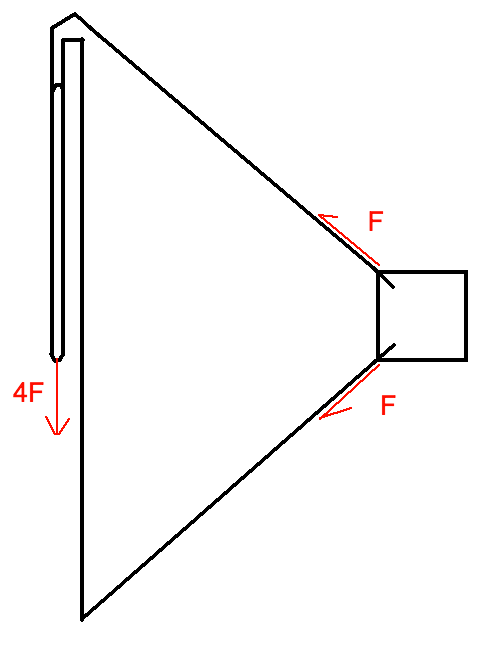
Mechanics/ChainSystem/untitled (14).png
