UniKlo/PaintBot/Mechanics/Electric Circuits/Parts/Arduino/README.md

# Arduino Mega 2560

Arduino Mega used over Uno based on the need for more pins with enabled interupt function



[Arduino Mega 2560 Rev3](https://store.arduino.cc/usa/mega-2560-r3)

[Spc](https://www.notion.so/adb2639479f145caa5b0ce70e4ab9edb)
