UniKlo/PaintBot/Mechanics/Electric Circuits/Parts/Z-AxisMotor/README.md

# Z-Axis Motor





[MakerMade](https://www.notion.so/Z-Axis-Motor-6baaa2ee45644490919e24fb8d234756#8be04c113b9b4dc18f8a3315a136ec81)
