UniKlo/PaintBot/Mechanics/Electric Circuits/Parts/XYMotors/README.md

# XY Motors

### Gear Box Motors



**Specs:**

24V 100W 2500 RPM electric scooter motor. Powerful two brush permanent magnet design with 100% ball bearing construction. Includes 9 tooth sprocket for #25 chain. 12" long power leads with terminal connectors. Shaft rotation reversible by reversing power leads. Dimensions: 2-5/8" wide x 3-7/8" long excluding shaft, 4-7/8" long including shaft. Made by Unite®.Item # MOT-24100

**More Specs:**

Manufacturer: Unite Motor Co.
Model: MY6812B
Voltage: 24 volts DC
Output: 100 watts
Sprocket: 9 tooth #25 chain sprocket
Case Length: 3-15/16" (100 mm)
Case Diameter: 2-11/16" (68 mm)
Drive Shaft Length: 1-1/8" (28 mm)
Drive Shaft Diameter: 5/16" (8 mm)
Mounting Hole Distance: 1-9/16" (40 mm)
Torque: 0.34 N-m
Rated Speed: 2750 RPM

**Links:**

[MY6812 Motors - ElectricScooterParts.com](https://electricscooterparts.com/motors-my6812.html)

[Zhongfeng Li - 86-755-88301448 - Zhejiang Unite Motor Co.,Ltd. Contact information](http://zhejiangunite.en.hisupplier.com/contact.html)

[24 Volt 100 Watt MY6812 Electric Motor with 9 Tooth #25 Chain Sprocket](https://www.monsterscooterparts.com/rae124vo100w.html)
