UniKlo/PaintBot/Mechanics/Electric Circuits/Parts/PowerSupply/README.md

# 12v Power Supply



### MENZO 12v 30a Dc Universal Regulated Switching Power Supply 360w for CCTV, Radio, Computer Project

### Specifications:
Input Voltage: AC200V-240VOutput <br/>
Voltage: DC 12VOutput Current: 0\~30ANet<br/>
Weight: 700gram<br/>
Demension: 215x115x50mm<br/>
Shell Material: Metal case / Aluminum case<br/>
Safety Compliance: CCC / Rohs - High price-effective, reliability with industry standards<br/>
Built-in over voltage, over current, and short circuit protection<br/>
Working Temperature: 0\~40C<br/>
Storage Temperature: -20\~60C<br/>
Ambient Humidity: 0\~95% Non-Condensation<br/>

[](https://www.amazon.com/MENZO-Universal-Regulated-Switching-Computer/dp/B06VWV5YCH)
