UniKlo/PaintBot/Mechanics/Electric Circuits/Parts/H-Bridge/README.md

# H-Bridge




[IBT-2 H-Bridge with Arduino](http://www.hessmer.org/blog/2013/12/28/ibt-2-h-bridge-with-arduino/)
