UniKlo/PaintBot/Mechanics/Electric Circuits/Parts/SprayGun/README.md

# Spray Gun

[Amazon](https://www.notion.so/Spray-Gun-6b17225c23db4822bbd5602d9855e16e#60443f367fd04a318092554bae7f6389)
