UniKlo/PaintBot/Mechanics/How to Assemble/Pulley Weights/README.md

# How to Assemble Pulley Weights

## Materials

6x Clay Bricks <br/>
Aluminum strips <br/>
Bolts <br/>
Wing nuts <br/> 
Weight Connect <br/>
Acrylic cut chain guide

## Instructions
1. Bend Aluminum strips to hold 6 stacked bricks
2. Drill holes through top of aluminum strips
3. Place bricks inside encasing and seal by connect the bolt and wing nut at the top of encasing
4. Connect the acrylic cut chain guide and weight connect to the top of the encasing
