UniKlo/PaintBot/Mechanics/How to Assemble/Frame/README.md

# How to assemble Frame
| Pillars | Accessories | Connect Pillars | Motor Rack |
|:-:|:-:|:-:|:-:|
Frame Pillar | Frame pillar accessories | Frame horizontal | Frame Final

**Note: Ensure all wooden pieces are painted with waterproof paint**
## Assembling the Pillars
Frame Pillar

1. Construct base of pillar (recommend putting wheels on the bottom for ease of transportation for future usage)

2. Cut stud to desired height and connect it to the base

3. Cut stud to matching height and connect it to the previous stud

4. Cut stud to matching height and connect it to sides of the last two studs

**Repeat this process to create the second pillar**

## Adding Accessories
Frame pillar accessories

1. Check proper assembly of Pillars

2. Connect the wooden bracket close to the bottom of the pillar

3. Connect two Safety Braces close to the top of the pillar depending on your maximum operation range of the pulley weights

**Repeat this process for the second pillar**

## Connecting the Pillars
Frame horizontal

1. Check proper assembly of Pillars and Accessories

2. Cut stud to desired width and use it to connect the bottom of both pillars together

3. Cut stud to desired width and use it to connect the top of both pillars together

## Connecting the Motor Rack with Tensioner
Frame Final

1. Check proper assembly

2. Connect the Motor Rack with Tensioner to the top of both pillars
