UniKlo/PaintBot/Mechanics/How to Assemble/Motor Rack with Tensioner/README.md

# How to Assemble Motor Rack with Tension

## Instructions

Motor Assemble1

Motor Assemble2

- For each face of the Motor Rack, attach the bottom of the faces into each motor block with screws
- From there, assemble rest of Motor Rack
    - Place the motor inside the frame
    - install the tensioner with the motor
    - Join the cage with plywood and secure with cage bolts
    - place the 80 tooth gear and testing the alignment
    - put the small chain on
    - tighten the tensioner



### Attach Motor Rack to Pillar:

| Step | Picture | Description |
|:--- | :---: | :--- |
*1.* |  | The front brick metal bracket <br/> 2 bearings on each side of the wooden brick
*2.* |  | The back brick is secured by the giant bolt from the middle
*3.* |  | 2 bearings on each side of the wooden brick <br/> Plywood chain guider piece does not have a design
*4.* |  | 2 bearings on pully <br/> Holder block design is in the fusion <br/> Chain guider / bearing shaft is in the fusion
