UniKlo/PaintBot/img_gif/FinalAssemblyDrawing.jpg

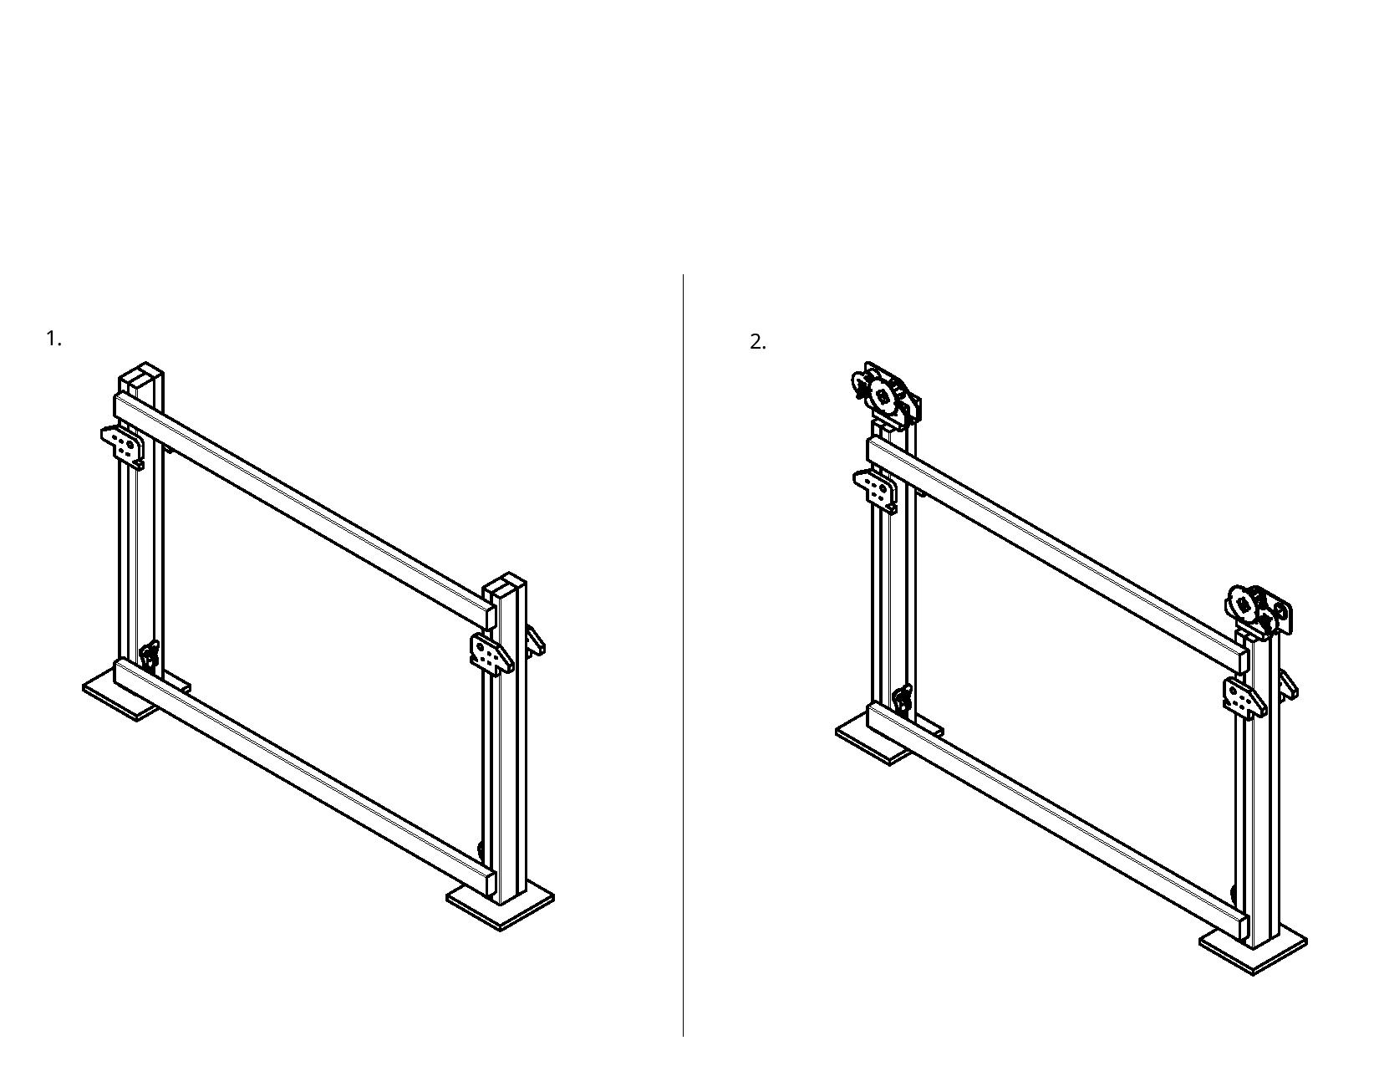
img_gif/FinalAssemblyDrawing.jpg
