UniKlo/PaintBot/img_gif/how to assemble center piece and spraygun 2.jpg

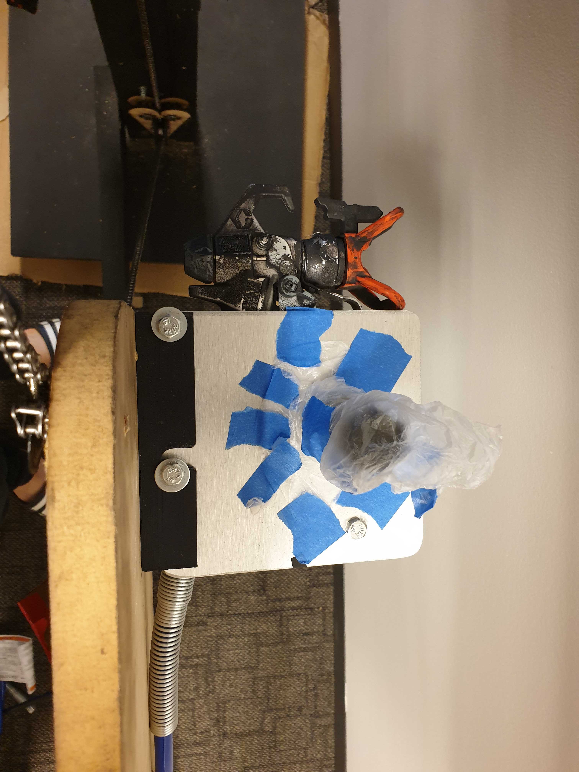
img_gif/how to assemble center piece and spraygun 2.jpg
