UniKlo/PaintBot/img_gif/how to assemble center piece and spraygun 3.jpg

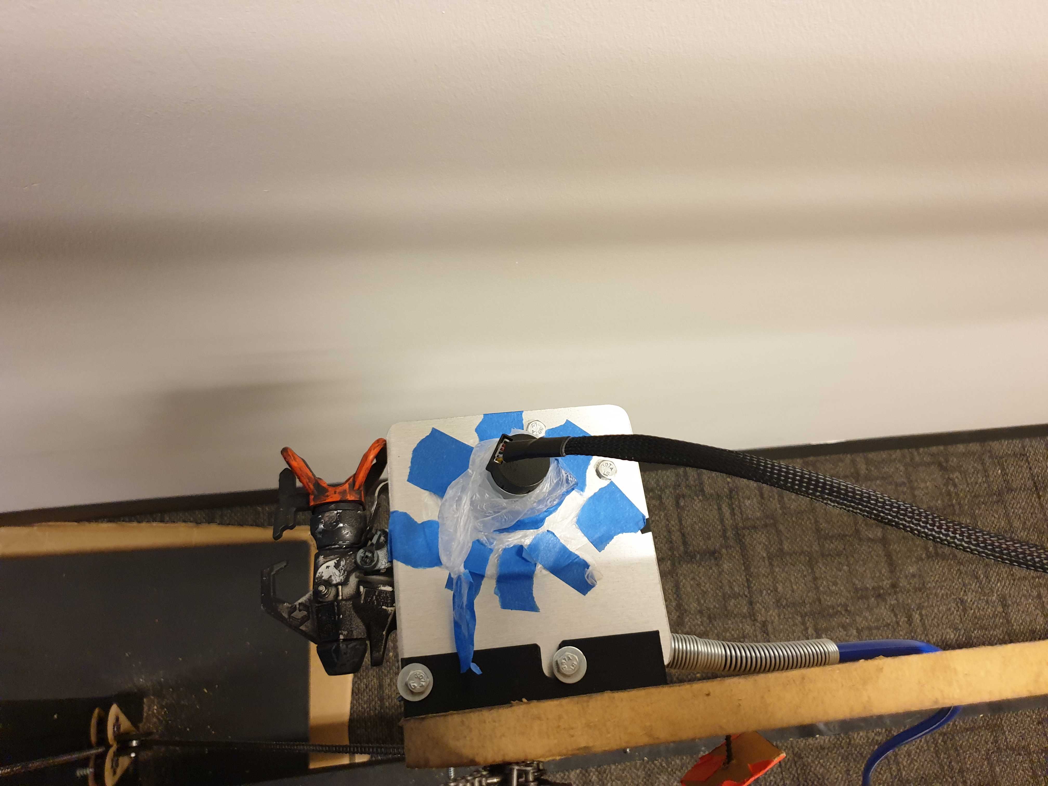
img_gif/how to assemble center piece and spraygun 3.jpg
