UniKlo/PaintBot/img_gif/MotorRackAssemblyDrawing.jpg

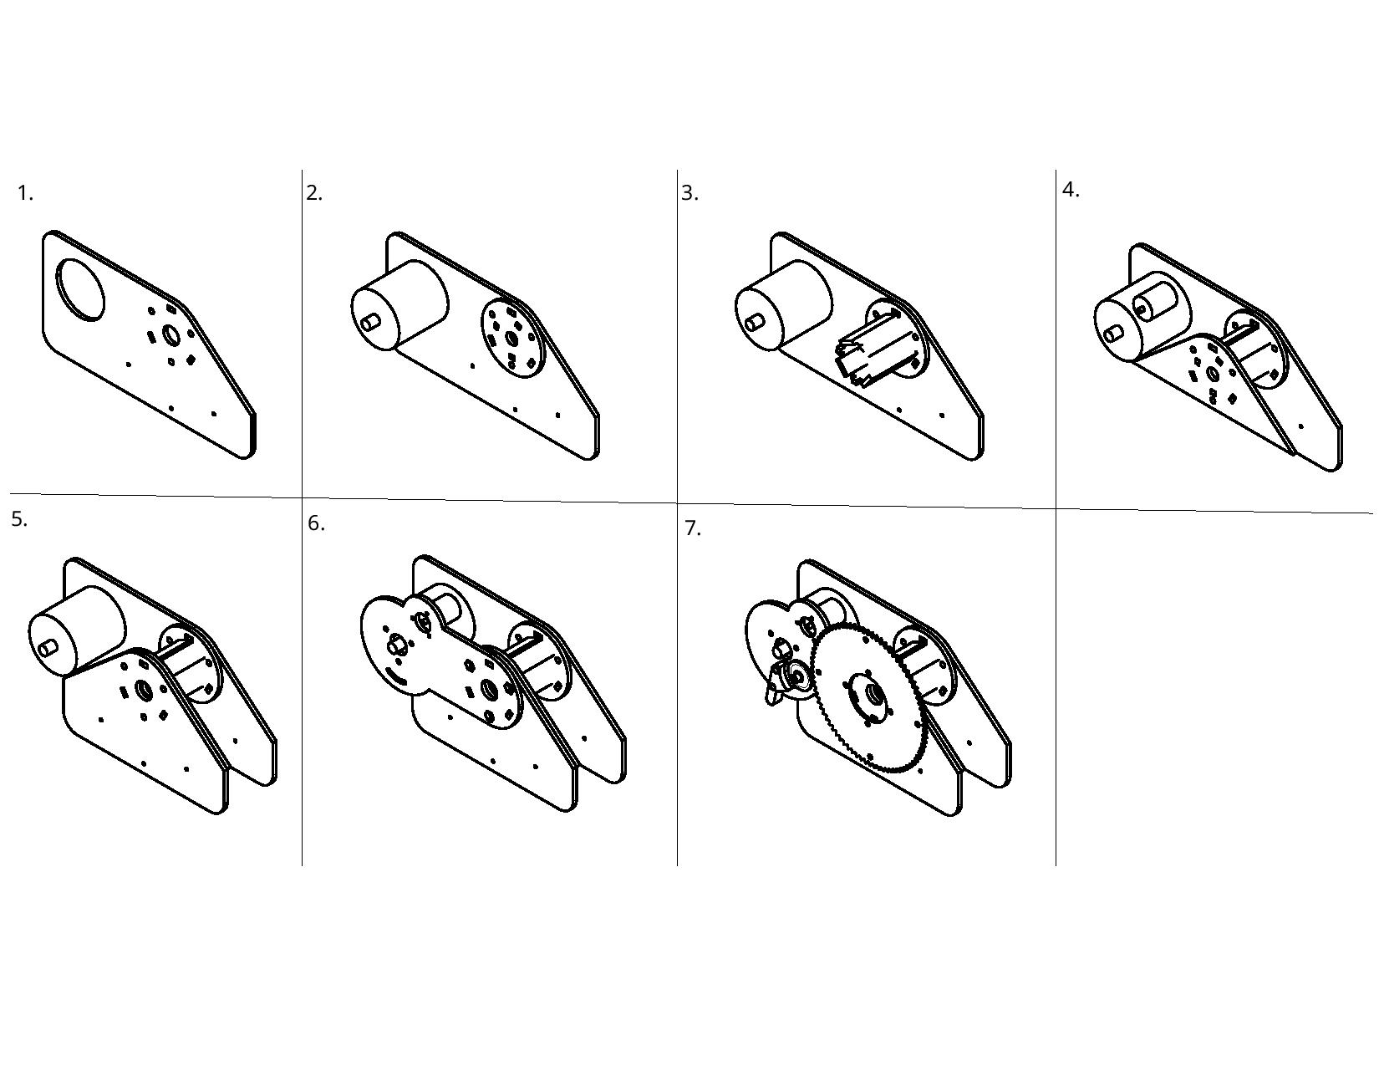
img_gif/MotorRackAssemblyDrawing.jpg
