UniKlo/PaintBot/img_gif/VerticalSupportAssembly.jpg

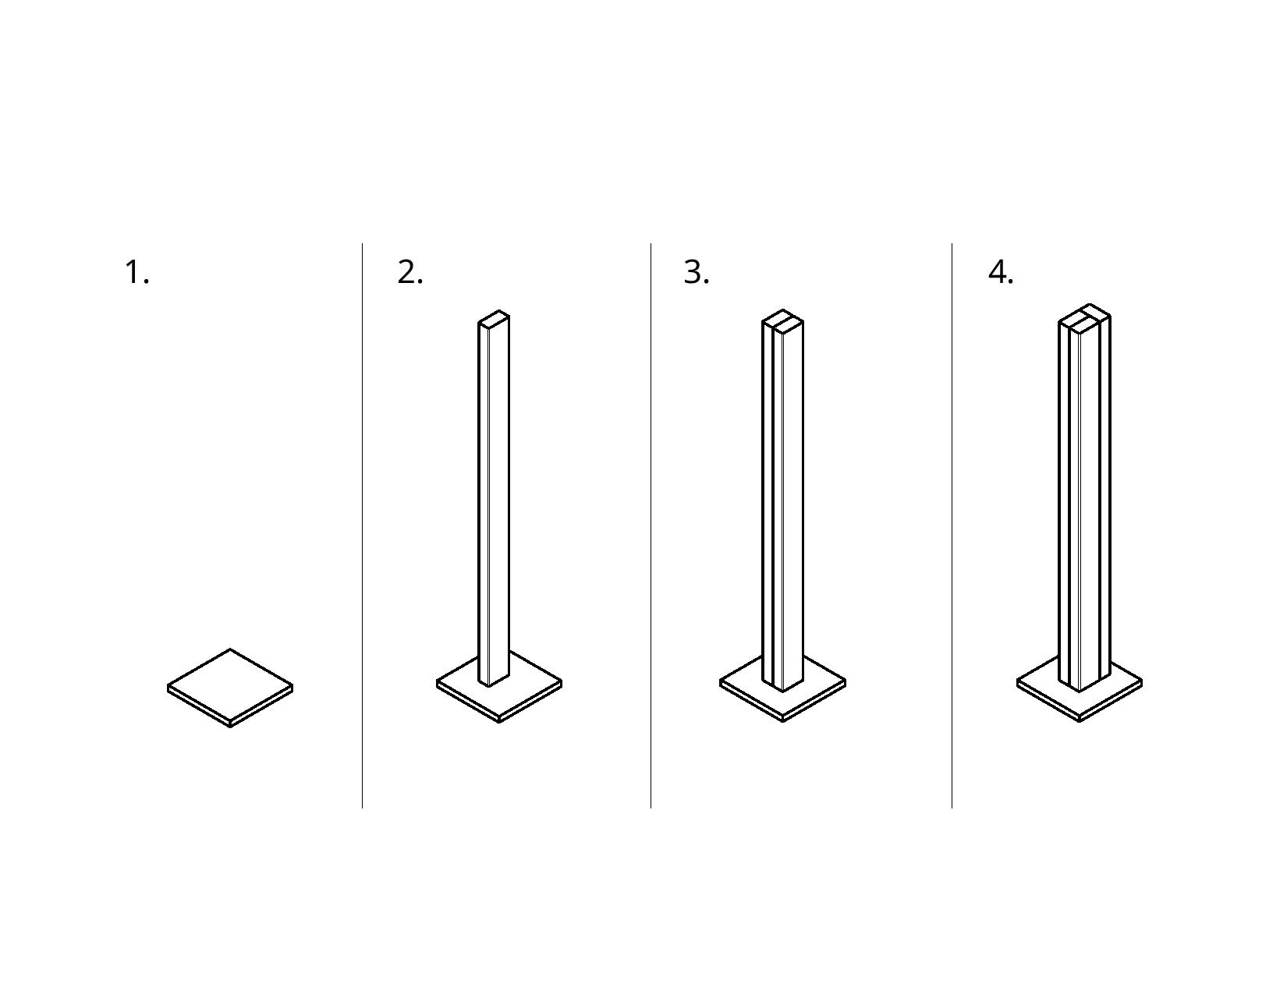
img_gif/VerticalSupportAssembly.jpg
