UniKlo/PaintBot/Mechanics/MotorRack/PaintBotMotorRack.pdf

2
1

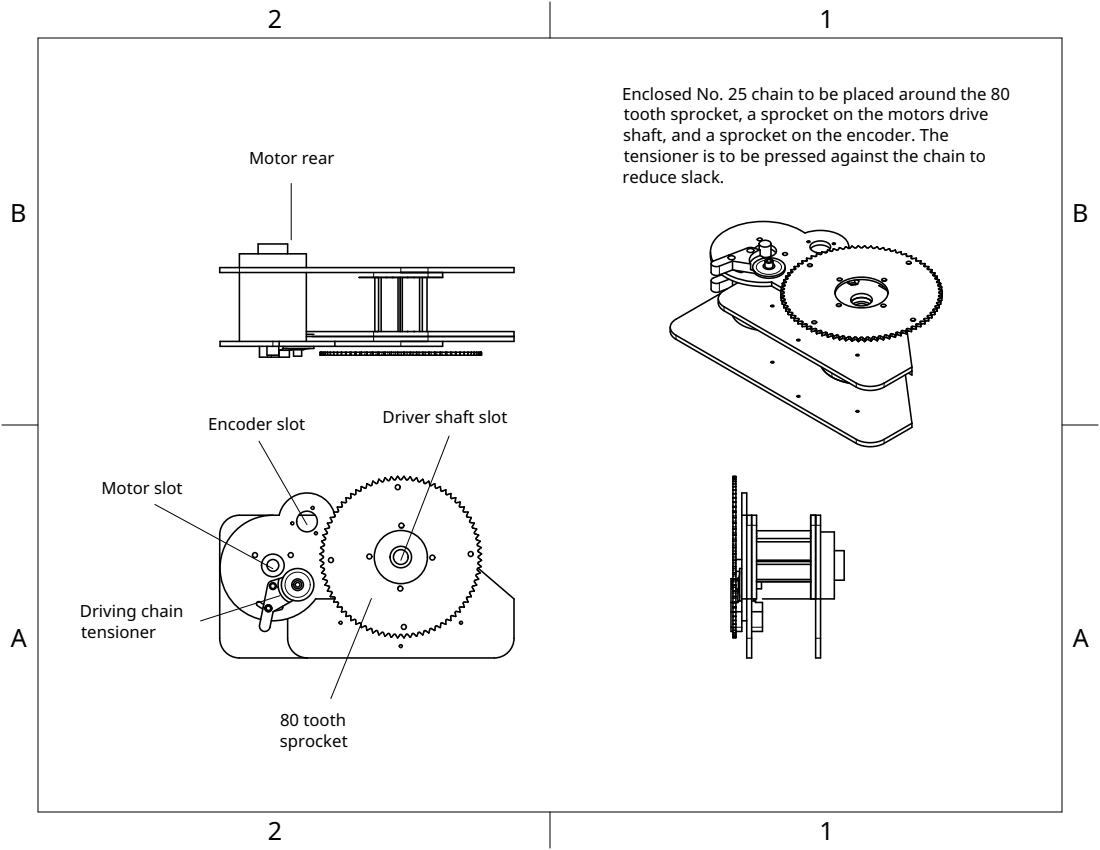
[picture p31: page 1]
Motor rear; Encoder slot; Driver shaft slot; Motor slot; Driving chain tensioner; 80 tooth sprocket

Enclosed No. 25 chain to be placed around the 80
tooth sprocket, a sprocket on the motors drive
shaft, and a sprocket on the encoder. The
tensioner is to be pressed against the chain to
reduce slack.
