UniKlo/PaintBot/(commit log)

2019-11-20 Create PaintBotMotorRack.pdf
    Added drawing of the motor rack with multiple views
2019-11-20 Moved the motor rack pdf to the proper folder.
2019-11-21 Added rough instructions on how the paint bot was assembled
2019-11-21 Changed assembly instructions from pdf format to jpg format
    Changed assembly instructions from pdf format to jpg format
