UniKlo/PaintBot/(notices)

Notices in the files:
Iterations/V-Plotter/MaslowCNC/Firmware-v1.27/cnc_ctrl_v1/Kinematics.cpp:
The Maslow Control Software is free software: you can redistribute it and/or modify
it under the terms of the GNU General Public License as published by
the Free Software Foundation, either version 3 of the License, or
(at your option) any later version.
